Cyberdensscode/openTPU/docs/mxu_systolic.md

# A 2D systolic MXU (`MXU_IMPL=2`)

Goal: an MXU that scales to MCOLS = 8 (4 and 12 must also build) on the xc7k480t without the
broadcast fan-outs and the fabric adder tree that make MCOLS = 4 fail timing today
([mxu_study.md](mxu_study.md); the MCOLS = 4 builds of 2026-09-28: fmax 101-119 MHz at 97% of the
slices, worst paths route-dominated). Results must stay bit-identical to the ISA simulator, and
decode must not lose cycles.

**Since the MX column** ([mx_mxu.md](mx_mxu.md) section 9, branch `mx-rtl-prod`): the systolic
array is the only MXU (`IMPL` 0 and 1 are gone; `MXU_IMPL` must be 2), and everything after the
chain ends is new. The four `otpu_colend` DSPs and the per-column fp32 epilogue (i2f, the two
scale multiplies, the isum_4 loop) are replaced by `otpu_mxce` (rtl/tech: eight DSPs that take
each chain end times m << sh and a ninth that accumulates the whole row exactly in 48 bits), the
result FIFO holds the rows' integers, and E = MCOLS/2 lanes the columns share do the epilogue
once per output. The array below (hops, skews, the PAIR select in `otpu_pe`, row-gated pops,
command overlap) is unchanged; the column-end and epilogue lines of this page describe the
previous design.

## What changes, what stays

The MXU is a D x MCOLS dot-product engine: each advance, one D = 128-byte weight chunk (one K-block
of one output row, or two 4-bit blocks under PAIR) meets MCOLS activation blocks (ACT RAM, one per
column = one activation row), and each column reduces its 128 int8 x int8 products exactly, then
runs a per-column fp32 epilogue. `IMPL=0` broadcasts the decoded chunk to every column and sums in
a fabric tree; `IMPL=1` (study) sums along D in DSP cascades but still broadcasts the (skewed)
weights, and supports neither 4-bit weights nor PAIR.

`IMPL=2` keeps the MXU's front and back unchanged:

- the issuer, the chunk / scale FIFOs, the pop logic, the ACT RAM interface;
- the fp32 epilogue per column, in the ISA's order: i2f (exact) -> x weight scale -> x activation
  scale -> [PAIR: + partner column] -> isum_4 partial loop -> (p0+p2)+(p1+p3) -> result FIFO ->
  drain (ACC / ASCALE read-modify-write, RMAX). Integer sums are order-free; every fp op here is
  not, so the epilogue is not touched.

and replaces the dot product (operands -> s4, the exact integer block sum) with a systolic array.

## The array

```
            column 0            column 1                 column MCOLS-1
w chunk -> decode -> skew -> [hop] -> ... -> [hop] -> ... -> [hop]
                      |          |                        |
position i (chain g = i/16, stage k = i%16), in each column:
    act[j][i] (ACT RAM, delayed 1 + k + j: one SRLC32E per bit)
    M  = act * w          (DSP48E1 M register, one product per DSP)
    P  = PCIN + M         (stage k > 0; stage 0: P = M)  -> the chain's running sum
chain ends (8 per column): sub-block b = chains 2b, 2b+1 (32 positions, the 4-bit sub-block)
    v[b] = (chain 2b + chain 2b+1) * m_b   (otpu_colend: DSP b's pre-adder, multiplier, M)
    s4   = v0 + v1 + v2 + v3               (the four DSPs' PCIN cascade, DSP 3's P register)
deskew: column j's s4 delayed MCOLS-1-j cycles -> all columns aligned for the epilogue
```

- **Weights flow, not broadcast.** The chunk is decoded once (int8; int4 / E2M1 nibbles -> int8),
  skewed once per chain stage (shared SRLs, delay k), and then moves one register hop per column:
  column j sees it j cycles after column 0. Each hop register drives one DSP per position and the
  next hop: fan-out 2, not MCOLS.
- **PAIR (4-bit, 2M <= MCOLS):** columns j < M take the chunk's low block, columns j >= M its high
  block. Both decoded streams flow (2 x 8 bits per position per hop) and each column selects its
  stream with a per-command constant (`hi0[j]`) in the DSP48E1 itself (`otpu_pe`, in
  `rtl/tech/xilinx7/otpu_tech_dsp.sv`; the generic and DSP48E2 versions in `rtl/tech/generic`,
  `rtl/tech/xilinxus`: A = low, D =
  high, INMODE selects one through the pre-adder), so there is no fabric mux per position and
  column. `hi0[j]` drives the INMODE of the column's 128 DSPs (a 128 fan-out, the OOC's worst path
  at MCOLS 4: 152 MHz); it only changes between commands whose rows do not overlap.
- **Activations** stay per column (ACT RAM rows). Their delay, 1 (the decode register) + k (chain
  stage) + j (column), is at most 1 + 15 + 11 = 27 cycles for MCOLS <= 12: one SRLC32E per bit,
  the same cost as IMPL=1's chain skew alone. The column delay is free.
- **One product per DSP.** Two int8 products per DSP48E1 is not exact on a cascade (the study:
  the low field overflows after 3 accumulations), so each column has 128 product DSPs, 4 sub-block
  multipliers and the epilogue's fp multipliers: 138 DSP per column, 1,106 at MCOLS = 8 of the
  part's 1920 (measured; the rest of the design uses ~150).
- **The 4-bit sub-blocks** are 32 positions = two 16-stage chains, so the sub-block multipliers
  m_b apply at the chain ends, exactly as IMPL=0 applies them to its group sums. int8 uses
  m_b = 1. Chain length is fixed at 16 (`CL`).
- **Latency** S0 -> aligned s4: 1 (decode) + 16 (chain) + 1 (product) + 2 (v, s4) + MCOLS - 1
  (column skew, then deskew) = MCOLS + 19 cycles (23 at MCOLS 4, 27 at 8), against 7 for IMPL=0.
  It is paid once per MM command's drain (the study measured +17 cycles per MM chain for
  IMPL=1: negligible).
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
