Cyberdensscode/openTPU/docs/serve.md

# otpu-serve: an OpenAI-style server on the card

`otpu-serve` serves one model on the card to any number of clients over an OpenAI-compatible
HTTP API. It keeps every user's context, on the card while it runs and in the host's RAM and
on disk after that, and it decodes several users' requests together in one run of the card.
In that it follows SGLang: a prefix cache of contexts (SGLang's RadixAttention), a hierarchy of
memory under it (its HiCache: GPU, host RAM, disk), and continuous batching.

```sh
otpu-serve --model qwen3 --backend board                     # http://127.0.0.1:8000/v1
otpu-serve --model qwen3 --backend board --kv-ram-gb 8 --kv-disk-gb 32 --kv-dir /data/kv
otpu-serve --model lfm2 --backend board --port 8001          # one sequence: requests in turns
```

Any OpenAI client works against it (the `openai` Python package, checked: models, chat plain and
streamed with usage, completions):

```python
from openai import OpenAI
c = OpenAI(base_url="http://127.0.0.1:8000/v1", api_key="none")
r = c.chat.completions.create(model="Qwen3-0.6B", messages=[{"role": "user", "content": "Hi!"}])
```

## The API

| Route | |
|---|---|
| `POST /v1/chat/completions` | the chat template as otpu-chat renders it; `stream` (SSE), `n`, `max_tokens` / `max_completion_tokens`, `temperature`, `top_p`, `top_k`, `repetition_penalty`, `seed`, `stop` (strings), `stop_token_ids`, `ignore_eos`, `stream_options.include_usage`, `chat_template_kwargs.enable_thinking`, `skip_special_tokens`; content as a string or text parts (and `image_url` parts and `max_slices` on a model with a vision side) |
| `POST /v1/completions` | a prompt string or token ids, `echo`, the same sampling and stops |
| `POST /generate` | SGLang's native call: `text` or `input_ids` (one, or a list), `sampling_params` (`max_new_tokens` (default 128), `temperature`, `top_p`, `top_k` (-1: all), `repetition_penalty`, `stop`, `stop_token_ids`, `ignore_eos`, `n`), `stream` (each event the whole text so far); `output_ids` and `meta_info` (prompt, completion and cached tokens, `finish_reason`, `e2e_latency`) |
| `GET /v1/models` | the model, its context length (`max_model_len`) |
| `GET /v1/stats` | the queue, throughput, the slots, the KV store and prefix cache, the steps' timing |
| `GET /health`, `/health_generate` | ok; a streamed MoE's 503 `warming` while its expert pool is read into the page cache (below) |
| `GET /get_model_info`, `/get_server_info` | |
| `POST /flush_cache` | forget every saved context and what idle slots hold |
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
