Cyberdensscode/openTPU/docs/img/asic-small-candA-macros.png

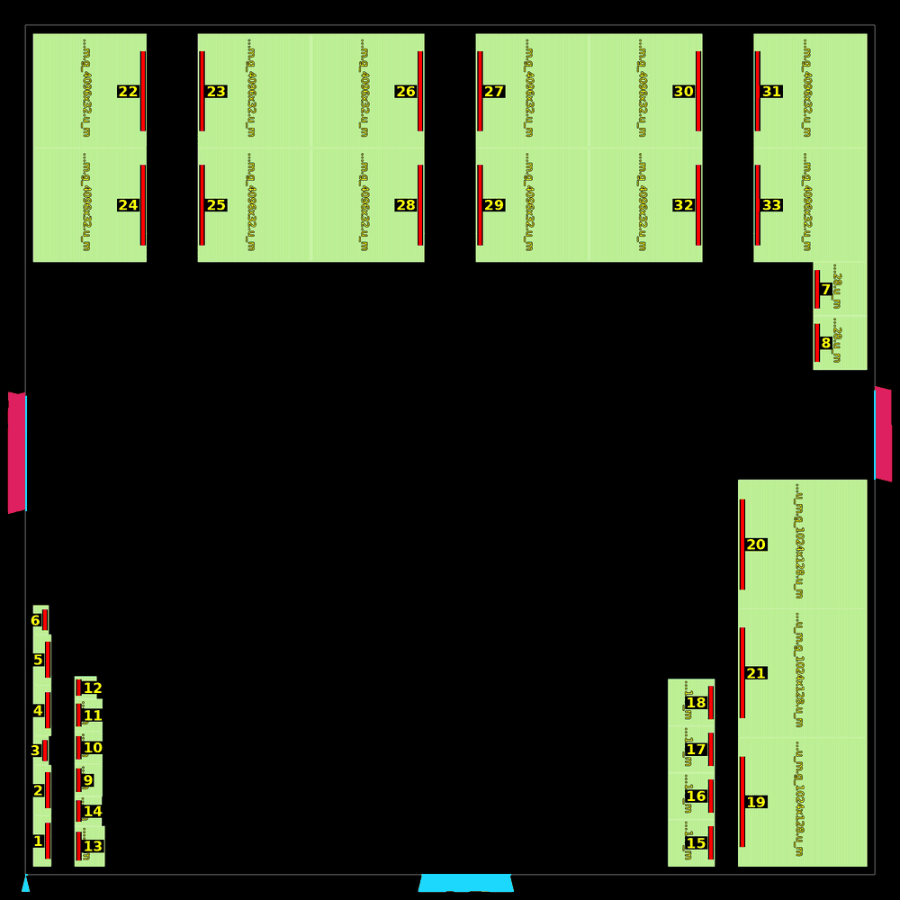
docs/img/asic-small-candA-macros.png
