Cyberdensscode/openTPU/docs/img/asic-small-candA-routed.png

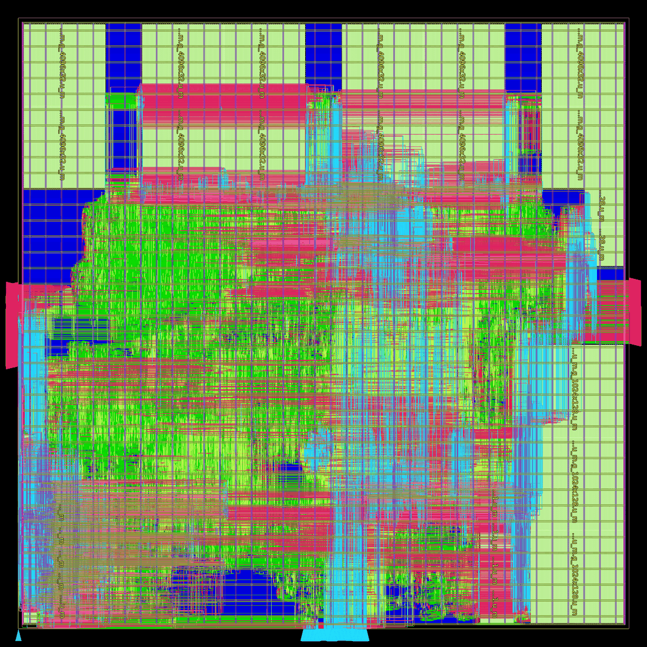
docs/img/asic-small-candA-routed.png
