Cyberdensscode/openTPU/docs/img/asic-small-candB-macros.png

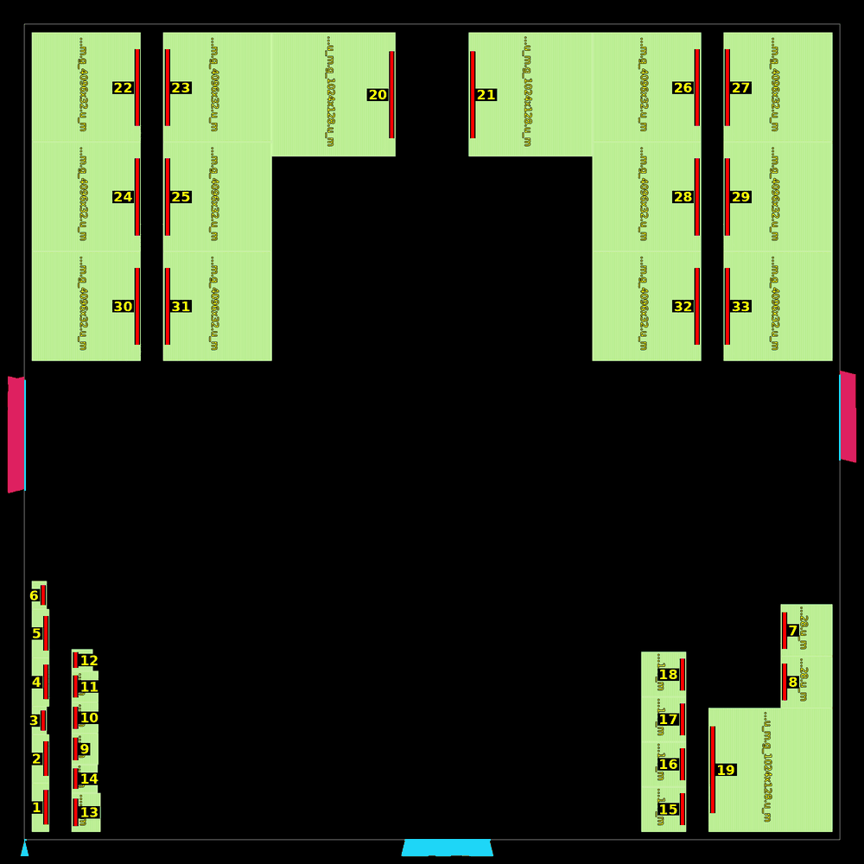
docs/img/asic-small-candB-macros.png
