Cyberdensscode/openTPU/asic/nangate45/results/small/final_all.png

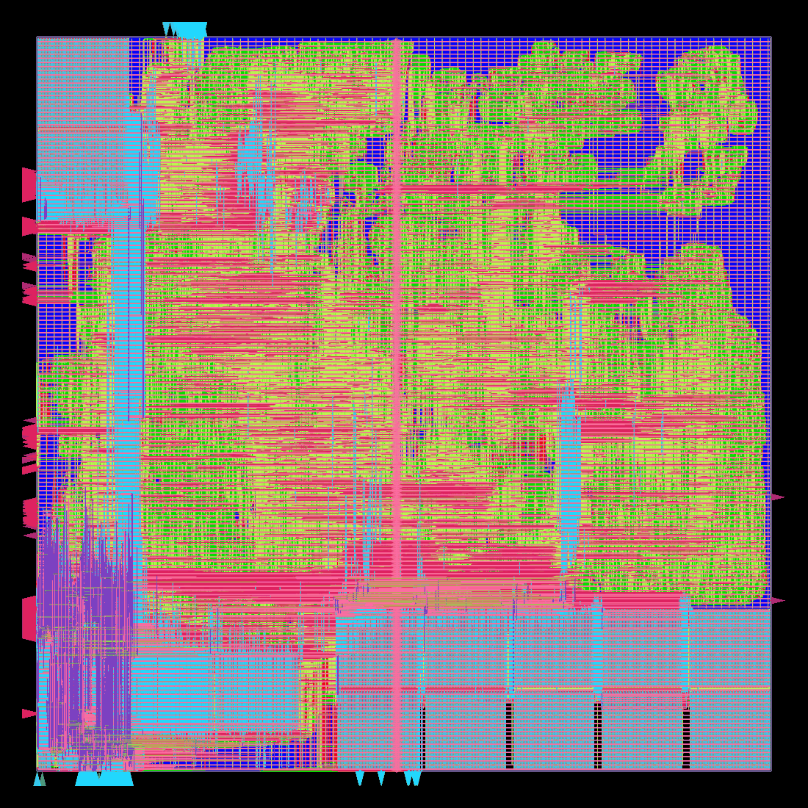
asic/nangate45/results/small/final_all.png
