Cyberdensscode/openTPU/opentpu/host/smi.py

"""otpu-smi: the state of openTPU cards, like nvidia-smi.

    otpu-smi                      one table per device (/dev/xdma*): bitstream, link, DDR3
                                  calibration, temperature, power (measured or estimated),
                                  DRAM, utilization over a short interval, the owning process
    otpu-smi -l 1                 again every second (utilization over each second)
    otpu-smi --json               the same as JSON (a list, one object per device)
    otpu-smi -q                   every detail, raw counters included
    otpu-smi --dev /dev/xdma1     one device (repeatable)
    otpu-smi --sim                the Verilator board model: counters over one run of the
                                  bring-up demo program (both samples in one simulation)
    otpu-smi --fake               an in-memory card with synthetic counters (demo, tests)
    otpu-smi -l 0.5 --samples 20 --csv util.csv
                                  loop, stop after 20 samples, append each to a CSV

The default table names the bitstream's capability bits (CAPS) and, in -l mode, a sparkline
of MAC / DRAM / RUN over the last samples.

A monitor: it only reads registers (and writes SNAP, which latches the free-running counters
into their shadows without disturbing anything), never takes the device lock, and reads the
runner's status file for the process, the model, DRAM use and tokens/s. Utilization is the
counter delta between two SNAPs over the UPTIME delta. On a register map 1 bitstream the
counters, the temperature and the power estimate are n/a.

Power is measured when the bitstream has the I2C pins (CAPS.i2c) and a PMBus device on the
card's I2C buses reports it (opentpu/host/i2c.py: read-only transactions under the I2C lock;
the first query scans the buses, later ones reuse <run dir>/<dev>.i2c.json). Otherwise it is
the estimate from Vivado's power report, marked "~ ... estimate". --no-i2c skips the buses.
"""
from __future__ import annotations

import argparse
import csv
import datetime as _dt
import glob
import json
import sys
import time
from pathlib import Path

from . import power as P
from . import regs as R
from .board import Board, rates
from .runstate import devname, read_status

VERSION = "0.3.0"
ROOT = Path(__file__).resolve().parents[2]
POWER_JSON = ROOT / "build" / "vivado" / "reports" / "power.json"


def find_devices() -> list[str]:
    return sorted(p[:-len("_user")] for p in glob.glob("/dev/xdma*_user"))


def pcie_link(dev: str) -> str | None:
    """'2.5 GT/s PCIe x8' from sysfs (the XDMA driver's class device), None if unknown."""
    base = Path(f"/sys/class/xdma/{devname(dev)}_user/device")
    try:
        sp = (base / "current_link_speed").read_text().strip()
        wd = (base / "current_link_width").read_text().strip()
    except OSError:
        return None
    return f"{sp} x{wd}"


# ------------------------------------------------------------------------------ sampling
def query(t, dev: str, interval: float = 0.2, prev: dict | None = None,
          power_json=POWER_JSON, sleep=time.sleep, i2c: bool = True) -> dict:
    """One device's state. Utilization over `interval` seconds (two snapshots), or since
    `prev` (the "counters" of an earlier query) when given."""
    b = Board(t, check=False, lock=False)
    ident = t.reg_read(R.R_ID)
    d = {"device": dev, "time": time.time(), "id": ident, "ok": ident == R.ID_OTPU,
         "link": "ok" if ident == R.ID_OTPU else
         "down (registers read 0xffffffff)" if ident == 0xFFFFFFFF else
         f"no openTPU (ID {ident:#010x})", "pcie": pcie_link(dev)}
    if not d["ok"]:
        return d
    i = b.info()
    d.update(regmap=i["regmap"],
             bitstream={"D": i["D"], "MCOLS": i["MCOLS"], "LANES": i["LANES"],
                        "core_mhz": i["core_khz"] / 1e3 if i["core_khz"] else None,
                        "build_id": i["build_id"], "ddr_mts": i["ddr_mts"]},
             calib=i["calib"], status=i["status"], running=i["running"], caps=i["caps"],
             temp_c=i["temp_c"])
    if b.v2:
        s0 = prev if prev else b.snapshot()
        if not prev:
            sleep(interval)
        s1 = b.snapshot()
        _derive(d, s0, s1, i["core_khz"])
    else:
        d.update(counters=None, util=None, sample=None, dram_gbs=None)
    st = read_status(devname(dev))
    d["process"] = st
    d["dram"] = st["dram"] if st and not st.get("stale") else None
    d["power"] = _power(d, power_json)
    d["measured"] = _measured(t, i["caps"]) if i2c else None
    return d


def _measured(t, caps: dict | None) -> dict | None:
    """Board power (PMBus) and temperature (LM73) over I2C, or None without the I2C pins."""
    if not caps or not caps.get("i2c"):
        return None
    from . import i2c as I2C
    try:
        return I2C.measured(t)
    except OSError:
        return None


def _derive(d: dict, s0: dict, s1: dict, core_khz: int | None) -> None:
    r = rates(s0, s1, core_khz)
    d["counters"] = s1
    d["sample"] = {"cycles": r["cycles"], "seconds": r["seconds"], "ipc": r["ipc"],
                   "dram_beats": r["dram_beats"]}
    d["util"] = r["util"]
    d["util"]["DRAM"] = r["dram_beats"] / r["cycles"] if r["cycles"] else 0.0
    d["dram_gbs"] = r["dram_gbs"]
    d["dram_rd_gbs"], d["dram_wr_gbs"] = r["dram_rd_gbs"], r["dram_wr_gbs"]


def power_report(d: dict, power_json=POWER_JSON) -> Path | None:
    """The Vivado power report for the loaded bitstream: power_json when it is not the default,
    else the saved build whose directory names the bitstream's BUILD_ID
    (build/deploy_*_<sha7>/reports/power.json), else the last build's."""
    if power_json and Path(power_json) != POWER_JSON:
        return Path(power_json)
    bid = (d.get("bitstream") or {}).get("build_id")
    if bid is not None:
        for f in sorted(ROOT.glob(f"build/*{bid:08x}"[:-1] + "*/reports/power.json")):
            return f
    return POWER_JSON if POWER_JSON.exists() else None


def _power(d: dict, power_json) -> dict | None:
    power_json = power_report(d, power_json)
    pj = P.load(power_json) if power_json else None
    if pj is None or not d.get("util"):
        return None
    e = P.estimate(pj, d["util"])
    e["source"] = str(power_json)
    return e
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
