Cyberdensscode/openTPU/rtl/exp/mx_mxu/mx_top.sv

// EXPERIMENTAL (docs/mx_mxu.md): the out-of-context top of the MX MXU's datapath, from the
// chunk and the ACT rows to the read-modify-write lanes: NCOL physical columns of two stationary
// rows each (ROWS = 2 NCOL, the virtual MCOLS), the rows' 48-bit accumulators, PAIR's add, a
// result FIFO and E shared epilogue lanes. The family file (otpu_mx_x7.sv: pumped DSP48E1s,
// otpu_mx_us.sv: packed DSP48E2s) gives the columns, the front and the clocks. base_top.sv is
// today's datapath with the same surroundings. Every input is registered in clk_s (the ports carry
// no timing), the outputs too; the issuer, the FIFOs of chunks and scales, the TMEM addresses and
// RMAX are not here (the same in both).
//
// Chunk t (its inputs in cycle t at the ports): the 128-byte chunk (wf: 0 int8, 1 int4, 2 E2M1;
// h: a 4-bit chunk's high half without PAIR), its two scale words (low / high stream: dw [7:0],
// m_b [8+6b +: 6]), the rows' activation blocks and their exponent words (da: 4 x 8 bits), the
// row flags (v, first, last) and, with the row's last chunk, Sw[n]. Per command: hsel (a physical
// column's stream: PAIR puts the low rows in columns 0 .. NCOL/2-1 and the high rows in the rest,
// so row j's partner is row j + ROWS/2), pair, fmt, m (results per row), Sa[r], old / alpha (the
// RMW's operands, from TMEM in the MXU).
module mx_top
  import otpu_fp::*;
  import otpu_mx_fam::*;
#(
  parameter int NCOL = 2,
  parameter int E = 2,
  parameter int D = 128,
  parameter int RF = 64
) (
  input  logic                          clk_in,
  input  logic                          rst,
  input  logic [2*NCOL-1:0][D-1:0][7:0] x_in,
  input  logic [D-1:0][7:0]             chunk_in,
  input  logic [1:0]                    wf_in,
  input  logic                          h_in,
  input  logic [31:0]                   sw_lo_in,
  input  logic [31:0]                   sw_hi_in,
  input  logic [2*NCOL-1:0][31:0]       da_in,
  input  logic [NCOL-1:0]               hsel_in,
  input  logic                          pair_in,
  input  logic                          fmt_in,
  input  logic [7:0]                    m_in,
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
