Cyberdensscode/openTPU/(commit log)

2026-10-08 otpu-chat keeps the KV cache across turns: a turn rolls the context back to the common prefix of its rendering and what the device holds (Engine.rollback) and feeds the rest, instead of re-prefilling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
    opentpu/llm/snapshot.py: the KV caches go back to any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
2026-10-08 tools/qual/chatkv.py: the card check of a chat's KV cache across turns: a scripted greedy conversation through Chat (--backend board; isa / board-sim for a dry run, at the card's configuration), each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
    [chatkv.py]
2026-10-08 Snapshots on the host keep a slice's regions as one array (restored by offset, as the device area's layout: the same bytes for either DeltaNet state slot whatever their regions' joins); test_mtp_roll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
2026-10-08 tools/qual/chatkv.py: no cycles printed on the ISA simulator (it counts none: tokens and runs)
2026-10-08 Chat passes logits=False only for a prompt's part up to the snapshot (a stateful engine's): an engine whose prefill_chunks takes the tokens alone runs as before (test_host's StubEngine: test_chat_tur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
    [chat.py, chat_tui.py]
2026-10-08 streamed: moe_card's engine wiring as a library (opentpu/host/streamed.py), for otpu-chat and moe_card alike, and pack_pool sums. streamed.engine builds a streamed MoE's Engine with the settings meas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
    [moe_card.py, pack_pool.py, streamed.py]
2026-10-08 otpu-chat: MoE models bigger than the card's DRAM, their experts streamed (--model lfm2-8b, qwen35-35b, gemma4-26b), and the scripted chat that checks them on the card (tools/qual/chatmoe.py, chatmoe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
    [chat.py, chat_tui.py, chatmoe.py, test_chatmoe.py]
2026-10-08 docs: chatting with a streamed MoE (docs/offload.md 14, docs/host.md 6, README). How to chat with LFM2.5-8B-A1B, Qwen3.5-35B-A3B and gemma-4-26B-A4B; where the pool goes (pool-fp4.bin beside the chec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
2026-10-08 otpu-chat: a default top-k above 64 (or none) becomes 64, every model alike, so that the decode loop stays on the card (the user's decision; LFM2.5-8B-A1B's generation_config.json asks for 80, which 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
2026-10-08 Streamed MoE chats roll back too (on chat-kv): otpu-chat and chatmoe.py pass snapshots=1 through streamed.engine (Engine's own), so a turn whose rendering parts from what was fed rolls back to the la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
2026-10-08 progcache: the host's runtime variables out of the key. otpu-lock runs every command with OTPU_LOCK_HELD and its pid in OTPU_LOCK_PID; both were in the key (every OTPU_* variable but RUNTIME_ENV's), 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
    [progcache.py, test_progcache.py]
2026-10-08 A whole-image cache (opentpu/imgcache.py): a model opened before opens in seconds. Engine builds its image through imgcache.build: keyed by the checkpoint (its config.json and weight files' names, si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
    [chat.py, imgcache.py, prebuild.py, test_imgcache.py]
2026-10-08 otpu-chat loads the tokenizer on a thread while the model loads (load_tokenizer): importing transformers, and torch with it, took 2.5 s of a warm open's 3.2 s on omarchy, before the image was read; n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
2026-10-08 Gemma 4 and the image caches; an image cache it cannot write is no error. gather.pack_records (Gemma 4's PLE records, whose fp4 search took 697 of 773 s of a build on one core) quantizes its blocks w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
    [imgcache.py, test_gemma4.py, test_imgcache.py]
2026-10-08 qcache.Batch hashes and reads the cache on threads: a build whose matrices are all in the 4-bit cache (a new KV capacity, the first open after any source change: the image cache misses) hashed 9.7 GB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
2026-10-08 docs: parallel image builds and the image cache. board.md, a new section (Image builds: in parallel, and cached whole): the 16-minute cold open of 2026-10-08 and why, quantize_rows' row pieces (one c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
2026-10-08 test_imgcache: a MoE through the image cache. A tiny Qwen3.5-MoE checkpoint on disk (fused expert tensors, as the real ones) with two expert slots a layer: the hit's image is the build's, and its eng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
    [test_imgcache.py]
2026-10-09 docs/offload.md 14.5: Qwen3.5-35B-A3B's chat on the card (opentpu, build 1025907f, tree 171a1b50), against its ISA reference (24a7e3f8, omarchy): both turns' tokens the same; 1720 slots, the prompt l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
2026-10-09 MODELS: Gemma 4's short names are the instruct checkpoints: gemma4 gemma-4-E2B-it, gemma4-26b gemma-4-26B-A4B-it, and gemma4-e4b gemma-4-E4B-it (new). The base checkpoints (gemma-4-E2B, ...) have no 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
    [test_autodecode.py]
2026-10-09 otpu-chat with Gemma 4's instruct templates. A reply's text keeps the special tokens the model wrote (Detok, Chat._finish: skip_special_tokens=False): Gemma 4 marks its thinking channel's ends specia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
    [chat.py, chat_tui.py, test_chatkv.py, test_host.py]
2026-10-09 otpu-chat --backend isa (the default) runs Gemma 4 in the card's configuration: the simulators' default is the design's two slices, onto which Gemma 4 (one KV head) does not map, so a Gemma chat on t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
    [chat.py, test_gemma4.py]
2026-10-09 tests: test_chatmoe's tiny checkpoints carry a chat template (otpu-chat refuses a checkpoint without one: test_otpu_chat_runs_a_streamed_moe and test_otpu_chat_clamps_the_models_top_k stopped there);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
    [test_chatmoe.py, test_validate.py]
2026-10-09 chatkv.py on Gemma 4: its recording sampler takes the model's soft cap (Chat refuses a sampler of another one: the tool stopped at 'the sampler's softcap None is not the model's 30.0' before its firs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
    [chatkv.py, test_chatkv.py, test_gemma4.py]
2026-10-09 formats_scan.py ppl --ids FILE: score the formats on another text's token ids (a JSON list, or an object with ids). tools/chat_text.py makes such a text from a chat: an instruct model's own replies t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
2026-10-09 test_gemma4's test_otpu_chat_on_the_isa_simulator: ask_plain's stream taken at the call (as test_chatmoe's), so the reply's line is captured when another test imported chat.py first (its default sys.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
    [test_gemma4.py]
2026-10-09 formats_scan.py scan --ids too (ppl's: another text's token ids). test_gemma4's test_formats_scan_text: docs/isa.md's ids start with <bos> for a Gemma 4 checkpoint whose tokenizer adds none, --ids re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
    [formats_scan.py, test_gemma4.py]
2026-10-09 formats.MIXES: no mix for Gemma 4 E2B: on gemma-4-E2B-it, the chat's checkpoint, every mix fails the rule, so otpu-chat's --wformat auto takes int8 (the fp4 PLE table, the int8 head; 6.37 tok/s on th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
    [perf_qwen.py, refs.py, test_autodecode.py, test_gemma4.py]
2026-10-09 formats_scan: a Gemma 4 variant's PLE table from its image laid out in unbounded DRAM (the placement is by the card's 4 GiB either way), so a reference that does not fit the card has one: E4B's int8 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
    [formats_scan.py, test_gemma4.py]
2026-10-09 gemma4: E4B's formats by fit are gemma-4-E4B-it's pick, the head and the gate / up projections of the first half of the own-KV layers in fp4 (head=fp4,gateup@0-11=fp4; Spec.fit_formats), three layer 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
2026-10-10 targets: one file per target (targets/*.toml: ypcb-00338, bcu1525, nangate45, nangate45-small) and opentpu/target.py, the loader everything derives from (Config, the simulators' uarch, the tops' para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
2026-10-10 rtl: the cell families and the FPGA shell (docs/targets.md "The RTL's layers"). The systolic MXU's cells otpu_pe and otpu_colend leave otpu_mxu.sv for rtl/tech/<family>/otpu_tech_dsp.sv: generic (the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
2026-10-10 host: otpu-selftest / otpu-diag name the target a map-4 bitstream was built from (board.config_summary: its slices and channels, DDR3 / DDR4 from the target), target.by_platform; README points at doc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
2026-10-10 bcu1525: the board's pins, DDR4 memory core and Vivado flow, before the hardware (docs/bcu1525.md). Pins: boards/bcu1525/scripts/gen_pins.py writes constraints/ddr4_c0..3.pins.xdc and bcu1525_pins.xd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
    [csr.csv]
2026-10-10 otpu_board: S slices (parameter S, default 1), each on two memory channels (slice s on n_* 2s and 2s + 1) through its own otpu_native_dram, the collective unit across them (gnt the AND of every slice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
    [otpu_board.sv, otpu_chmem.sv, otpu_ctrl.sv, otpu_native_mem.sv, tb_board.sv]
2026-10-10 host: multi-slice boards. board.channel_map(info): the card's channels from a register map 4 bitstream's CFG_* registers, channel j = 2s + c (slice s's channel c) at j x the bytes a slice addresses p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
    [board.py, fake.py, regs.py, test_board.py]
2026-10-10 bcu1525: the target's bring-up values and the DMA map the host now uses. targets/bcu1525.toml: mem_mts 1600 (LiteDRAM's USPDDRPHY at 200 MHz first; the RDIMMs are DDR4-2400, 300 MHz once the controll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
2026-10-10 docs/bcu1525.md: phase 2's state. Section 5: XDMA's DMA window is 8 GiB, channel j = 2s + c at j x 2 GiB (board.channel_map from CFG_SLICES / CFG_DRAM; the YPCB's two channels are the same rule), the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
2026-10-10 bcu1525: the board top. rtl/boards/bcu1525/otpu_fpga_top_bcu.sv: the four DIMMs' 300 MHz clocks (IBUFDS + BUFG each; clk300_1, SLR1, also the block design's), one otpu_ld4 per DIMM (its CSRs on core_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
    [otpu_bcu_sys.sv, otpu_bd_wrapper_stub.sv, otpu_fpga_top_bcu.sv, target.py, test_target.py, unisim_dsp48e2_stub.sv, unisim_stubs.sv]
2026-10-10 bcu1525: a first SLR floorplan (unverified) and the top's crossing constraints. constraints/bcu1525_floorplan.tcl (unmanaged Tcl, late, implementation): slice 0 with DIMM C0's core and bridge in SLR0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
    [board.py, check_offline.py, otpu_axi_split2.sv, otpu_bcu_sys.sv, tb_board.sv, test_board.py]
2026-10-10 bcu1525: DDR4 bring-up over the cores' CSRs (otpu-ddr4) and two fixes in the DDR4 core. opentpu/host/ddr4.py: DIMM d's LiteDRAM core in BAR0 at R_DDR4 + d x DDR4_STRIDE (0x40000 + d x 0x10000, vivado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
    [csr.csv]
2026-10-10 otpu-ddr4: the BIST holds the device lock (a DMA transport's: it writes over the DRAM; status and ecc read registers, as otpu-smi), and the tool closes the transport it opened. tests/test_ddr4.py 3 p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
2026-10-10 otpu_board: at S > 1 the control, the status and the collective cross SLRs through registers. Every signal between a slice and the shell goes through two otpu_xr stages each way per slice (g_xs: u_*_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
    [otpu_board.sv, otpu_coll.sv, otpu_ctrl.sv]
2026-10-10 bcu1525 floorplan: the board's new crossings. pb_slice0 / pb_slice1 take each slice's otpu_xr receive stage down, send stage up and otpu_coll_port (slice 0 also its activity bundle's send stage), pb_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
    [otpu_board.sv]
2026-10-10 bcu1525: the day-one checklist and a Vivado preflight. run_vivado.sh runs scripts/preflight.tcl first (PREFLIGHT=0 skips it): the target's part (T_PART) must be installed (exit 2: the installed famil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
    [diag.py, selftest.py, test_ddr4.py, test_host.py]
2026-10-10 docs/bcu1525.md section 7: the TMEM_URAM=1 estimate measured (yosys PID 22666, the same one-slice xcup run with the 48 TMEM bank memories marked ram_style ultra, as tmem_uram.xdc marks them; 48 objec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
2026-10-10 tests/test_board.py: test_bar_and_gather_across_slrs_on_board_model, BAR and GATHER through the BCU1525's SLR crossings (otpu_board S = 2, g_xs: otpu_coll_hub and a port per slice) on the board model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
    [test_board.py]
2026-10-10 tmem: a banked implementation for ASICs (TMEM_IMPL 1): three copies of 1R1W bank RAMs instead of one per read port
    otpu_tmem IMPL 1: NCP copies (CPY: each read port's copy), each LANES banks of one otpu_ram_1r1w
    (rtl/tech/generic/otpu_tech_ram.sv, the technology RAM wrappers: 1R1W, 1R1W with byte enables,
    1RW; inferred here, SRAM macros in an ASIC's rtl/tech). A copy's bank serves the one port granted
    in it, its address from that port's granted lanes (r_en); writes go to every copy (WPB 1); the
    registered write stage, the bypass and the lanes' data path are IMPL 0's. IMPL 0 (the FPGA's, a
    copy per read port) is unchanged: its bank arrays and their code stay where they were.
    otpu_slice TMEM_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
2026-10-10 The core's large RAMs on the technology RAM wrappers; tools/asic/fakeram.py, 1RW and 1R1W abstract SRAM macros for NanGate45
    The memories an ASIC builds from SRAM macros now go through rtl/tech's otpu_ram_1r1w /
    otpu_ram_1r1w_be (the generic file infers them, with the ram_style the FPGA had; the ASIC file
    maps them onto macros): IMEM (otpu_seq u_imem; its simulation load writes the RAM's words, the
    wrapper's zero start off for it: ZERO), the ACT RAM's pieces and block scales (u_act with byte
    enables, u_asc), the DMA's chunk buffer (u_lb), the MXU's chunk FIFO (u_fd, was otpu_ram_sdp, which
    stays for now) and scale FIFO (u_fs: ws0r is its read register), the stream engine's delay buffer
    (u_ub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
2026-10-10 asic: the ASIC block (rtl/asic/otpu_asic_top.sv), the macro-tiled technology RAMs and the NanGate45 flow through OpenROAD-flow-scripts
    rtl/asic/otpu_asic_top.sv: one slice (TMEM_IMPL 1, RPB 1, WPB 1) and its collective unit, the
    slice's memory ports at the boundary (the DRAM side, PHY and controller, is the platform's).
    rtl/tech/asic/otpu_tech_ram.sv: otpu_ram_1r1w / _1r1w_be / _1rw tiled onto leaf macros of at most
    128 bits x 4096 words (depth tiles with a registered read select); the leaves are generated per
    design.
    tools/asic/flow.py prep | run | report | all POINT: elaborate once with yosys-slang (the leaves as
    parameterised black boxes) to list the RAM tiles, generate their macros (fak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
2026-10-10 targets: the technology RAMs in every file list (target.TECH: rtl/tech/generic/otpu_tech_ram.sv for generic / xilinx7 / xilinxus, rtl/tech/asic/otpu_tech_ram.sv for asic; rtlsim.RTL_SOURCES, the boar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
2026-10-10 tech: tests/test_tech_ram.py (sim/tech/tb_tech_ram.sv): the ASIC's technology RAMs, tiled onto tools/asic/fakeram.py's macro models with flow.sram_map's leaves, read what the generic ones read, cycle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
    [otpu_tech_ram.sv, tb_tech_ram.sv, test_tech_ram.py]
2026-10-10 tests: test_tmem_dump_is_the_ram faults VPU B's copy (port 4) instead of VPU A's: port 4 holds a TMEM copy of its own in both TMEMs (a copy per read port, and the banked one's copy 1), port 3 reads t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
    [test_rtl.py]
2026-10-10 asic: tools/asic/paths.py names a run's paths by unit and stage. paths.tcl (ORFS `make run`, any stage: 6_final, 4_cts, 5_route) writes the worst full paths, every endpoint's worst path (summary) and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
2026-10-10 asic: flow.py report takes the latest stage's report (6_finish, 5_global_route or 4_cts_final): the worst slack with the ports' 20% budgets (fmax_io_mhz), the clock's minimum period register to regis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
2026-10-10 asic/nangate45/README.md: the points by target (small = nangate45-small, card = nangate45), the commands (prep / run / report, resuming and cleaning a stage, stopping at a make target, paths.py at an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
2026-10-10 docs/asic.md: the results so far. nangate45-small after global route: 7.02 mm² die, 1.18 mm² of standard cells (590 K instances), 27 macros (233 KiB, 1.31 mm²); 416 MHz register to register (422 afte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
2026-10-10 tests: test_asic_flow.py (no OpenROAD): every ASIC target is a design point, a point's parameters are otpu_asic_top's with the target's values and its clock the target's core_mhz; the sources are the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
2026-10-10 asic: the SDC drops hold checks at the block's ports: the ideal virtual clock against the propagated core clock (~1.2 ns of insertion delay) made the input paths hold violations (nangate45-small: 218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
2026-10-10 asic: no standard-cell row narrower than 60 um (asic/nangate45/tapcell.tcl: the platform's tapcell with -row_min_width 60, TAPCELL_TCL): nangate45-small's final power-grid check failed (PSM-0069, VSS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
    [flow.py]
2026-10-10 docs/asic.md: nangate45-small routed and reported (signoff extraction): 7.02 mm² die, 1.18 mm² of standard cells (94 K flip-flops, 373 K gates), 27 macros 1.31 mm²; 419 MHz register to register with 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
2026-10-10 docs/asic.md: what the banked TMEM costs in cycles: a Qwen3-0.6B decode token on the RTL (tools/asic/tmem_cycles.py, omarchy) 4,819,205 cycles against 4,815,735 with a copy per port (+0.07%), results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
2026-10-10 docs/asic.md: nangate45 (the card's arch) synthesized and floorplanned: 30.6 mm² die at 35%, 4.04 mm² of standard cells (1.76 M instances), 113 macros 6.62 mm²; the area per unit (TMEM 4.05 mm², 3.99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
2026-10-10 bcu1525 + asic-flow: the BCU1525's file lists take the technology RAMs (rtl/tech/generic/otpu_tech_ram.sv after the DSP cells in boards/bcu1525/Makefile and vivado/create_project.tcl, as target.sourc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
2026-10-10 docs/asic.md: nangate45 (the card's arch) after CTS: 2.02 M instances, 4.36 mm² of standard cells, 113 macros on a 30.6 mm² die; 178 MHz register to register (5.60 ns), 156 MHz with the ports, 3.34 W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
2026-10-10 docs/asic.md: the card's fp stages after CTS: their own logic meets 2.5 ns (fmul s1 -> s2 +0.76 ns, fmul s2 -> the next s1 +0.46, fadd s1 -> s2 +0.95, s2 -> s3 +0.92) while every path into them fails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
    (cherry picked from commit 7f46b8803dfea87e72987526a34290d63a15dd0f)
2026-10-11 test_tourney after the RTL layers: every RTL file of the card's build (target.sources("ypcb-00338")) is some unit component's, the other targets' files (rtl/asic, rtl/boards/bcu1525, rtl/tech/asic, x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
    [test_tourney.py]
2026-10-11 decode_profile: the Board.write wrapper passes the slice argument through (Board.write(addr, data, s=0) since the multi-slice host). Its fixed (self, addr, data) raised TypeError on every Board.write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
    [decode_profile.py]
2026-10-11 size-general: the compiler, kernels and models take every size from the Config, so one tree compiles for the card, the BCU1525 (S = 2), the NanGate45 targets and the design point (docs/compiler.md "S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
2026-10-11 tests: each pytest session takes a device-lock / status directory of its own (OTPU_RUN_DIR = <tmp>/otpu-run-<user>-<pid>, removed at the end; the default is /tmp/otpu, shared by the host). A fake boa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
2026-10-11 test_se_vpu: the stream front's testbench compiles rtl/tech/generic/otpu_tech_ram.sv (otpu_se_tail's ub is an otpu_ram_1r1w since the ASIC RAM wrappers): its own file list missed it, %Error-MODMISSIN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
    [test_se_vpu.py]
2026-10-11 progcache: the cache key leaves out the modules no image build or compile runs (UNKEYED: lens.py, profile.py, hwtrace.py, reference.py, rtlsim.py, simtmp.py, llm/rtl_backend.py), so an edit to the pr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
    [imgcache.py, progcache.py, test_progcache.py]
2026-10-11 serve/kvio: a context's bytes on the host. The positional KV caches' first n positions (K rows, K scales, V^T tiles of vt_tile(cap) tokens, V scales; Gemma 4's _KV rows with their scales) in pages of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
2026-10-11 serve/store: the KV store on the host. BlobStore: byte blobs in RAM up to a budget, the least recently used spilled to files by a writer thread (read from memory while written), up to a disk budget p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
2026-10-11 serve/scheduler: the device's worker. One thread owns the Engine; requests (prompt ids, sampling, stop ids and strings, max_new) admitted up to max_running and run in turns: a new request continues t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
2026-10-11 serve/api: otpu-serve, an OpenAI-style HTTP API (the standard library's server). POST /v1/chat/completions (the chat template as otpu-chat renders it, thinking per chat_template_kwargs, content parts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
2026-10-11 llm/batch: batched decode steps on the device. Engine(batch=B, batch_area=True): the lookup tables serve every sequence (sequence 0 keeps the resident decode, the generate loop and the prompt runs), 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
2026-10-11 serve/batching: continuous batching over KV slots. BatchWorker on an Engine(batch=B, batch_area=True): up to B requests at once, each in its own slot; per iteration the waiting requests take free slo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
2026-10-11 serve_bench: sampled throughput levels (the model's sampling, seeded per client)
2026-10-11 batch: a step's head through _head (the chunk can be set in the area); Steps.timing (device cycles, compile waits, run time) in the batching worker's usage (step_timing)
2026-10-11 docs/serve.md: otpu-serve (the API, the KV cache's pages, store and prefix cache, requests in turns and batched in KV slots, the card's measurements of 2026-10-09: time-sliced 24-25 tok/s at 1-8 clie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
2026-10-11 tools/batch_bench.py: batched steps against the decode loop on one image (device Mcycles and wall time per run and per token, per row count, greedy and sampled; --trace: a decode step and steps of R 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
2026-10-11 batch: span programs. A step's program serves its rows for up to a block of steps: row r at position p_r + t, t the run-time step in the io block's step word (loaded and multiplied into the argument 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
2026-10-11 serve: the first token on the card, prompts in feed runs. A prompt feeds all but its last token; the last one is the request's first decode row (batched: a step's row with its Greedy / Sampler sink; 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
2026-10-11 batching: a prompt's join compiled ahead. AHEAD_JOIN (3) feed runs before a prompt is fed, the step it joins (the decoding requests that many steps on, its row at the prompt's last token) is compiled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
    [batching.py, test_batch_steps.py]
2026-10-11 batching: chunked prefill by a token budget, coming steps compiled ahead. Each iteration feeds the prompts being fed, oldest first, up to --chunked-prefill-size tokens (default 64; was one feed run o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
    [api.py, batching.py, test_serve_batching.py]
2026-10-11 docs/serve.md: the card's run of span programs and feed runs (6c3a1c75, 2026-10-09 19:40-19:45): 4 / 8 clients 77.7 / 75.7 tok/s (per-step programs: 53.3 / 50.1), 8 sampled 78.5 (46.3), TTFT at 8 cli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
2026-10-11 serve_bench: the users part (--users N, default 16; --user-tokens): every user's first turn at once, then every user's second turn at once (more users than slots: contexts from the slots, host RAM or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
2026-10-11 batch: Steps.timing splits a run's host time (the io write, start, wait, the picks' read); batch_bench prints them per run
2026-10-11 batch: fewer inline compiles when requests come and go (the card's 16-user run compiled 74 of 129 step programs inline, 4.9 s of 62). A step's rows in slot order (the worker's steps and _rows_at's pr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
2026-10-11 docs/serve.md: the card's 16 users on a 50 MB RAM tier (26 contexts spilled, 14 second turns from disk, replies equal to cold runs), host time per run (0.5 ms plus the wait), blocks of MCOLS slots an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
2026-10-11 serve: the engine's per-run stats trimmed to the last 1024 between iterations (one dict a device run, ~90k an hour batched: a server runs for days)
2026-10-11 otpu-serve: a listen backlog of 1024 (socketserver's 5: the card host reset one of 16 clients connecting at once, Linux with syncookies). Test: 64 clients connecting at the same moment
    [api.py, test_serve_api.py]
2026-10-11 batch: feed programs shared by every prompt. A feed run's program is compiled at its attention block's start plus its phase in feed_rows() (Steps._canon), so one program per slot and block serves eve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
    [batch_bench.py, batching.py, test_serve_batching.py]
2026-10-11 batch / batching: mixed runs (--mixed, off by default). With fewer decoding requests than MCOLS a step's MXU pass has spare rows; Steps.mixed runs the decoding rows and the oldest prompt's next token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
    [api.py, batching.py, test_batch_steps.py, test_serve_batching.py]
2026-10-11 batching: a request takes a free slot in the block of MCOLS slots holding the most requests (a step runs each block in a run of its own), before the longest prefix (another slot's is copied on the ca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
2026-10-11 docs/serve.md: slots packed into blocks, mixed runs (--mixed, off by default) and the card's arrivals A/B (session 12: default gap p50 / p99 / max 45 / 302 / 345 ms and TTFT 0.30-0.39 s; --mixed 45 /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
2026-10-11 progcache / qual refs: opentpu/serve out of the program cache's key and the references' source hash, as opentpu/host. The API server keeps no program in the cache and computes nothing of a reference,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
    [imgcache.py, progcache.py, refs.py, test_progcache.py]
2026-10-11 asic flow: native OpenROAD-flow-scripts first. ORFS_HOME names a clone with its tools built (checked: env.sh, tools/install/OpenROAD/bin/openroad; a half-built one is an error that says so); run then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
    [flow.py, test_asic_flow.py]
2026-10-11 asic/nangate45/results/small: the reference run of nangate45-small, native ORFS f395e4b6 on main 596d62fa (81 min on 20 cores, 15 GB peak): report.json (flow.py report), ORFS's 6_finish.rpt, the rout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
2026-10-11 docs/asic.md: the card's global routing, measured. The router's congestion report puts nearly all the overflow along the ACT RAM's macro block's inner edge and just past it (x 0.4-1.0 mm, y 0-1.4 mm)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
2026-10-11 imgcache: eviction weighs what a miss would cost again. An entry's header keeps its build's seconds (build_s), and over the size the least recently used go first with each build second per GB countin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
    [imgcache.py, test_imgcache.py]
2026-10-11 imgcache: a write under the free-disk floor drops the entries it outranks. It had been skipped, and over-the-size eviction never ran under the floor: on the card host on 2026-10-11 the image cache he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
    [imgcache.py, test_imgcache.py]
2026-10-11 imgcache: a build's look at the image leaves out the weights' entries. Gemma 4's image keeps the weights (_W), and the cache expanded every dict attribute into its entries: with lazy weights (qwen3.L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
    [imgcache.py, test_imgcache.py]
2026-10-11 imgcache: build seconds weigh an entry of this tree only. An entry's header keeps its tree (src: progcache.source(), what the key holds of the sources); another tree's entry goes by its last use alon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
    [imgcache.py, test_imgcache.py]
2026-10-11 bcu1525: the block design and the DDR4 core through Vivado on the free xcku5p (make ipcheck, omarchy with the UltraScale+ device files installed: bd, its seven IPs synthesized out of context, otpu_ld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
2026-10-11 bcu1525: make synthcheck, the whole project synthesized on another part (scripts/synth_check.tcl: create_project.tcl with OTPU_PART, the real block design and DDR4 cores, the top at S = 2, developmen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
2026-10-12 rtl/exp/tmem_pump (EXPERIMENTAL, in no file list): otpu_tmem_pump, the TMEM with its block RAM copies pumped at twice the core clock. A pumped copy is LANES true dual-port banks on clk_f: at each cor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
2026-10-12 TMEM_RQ: the banked TMEM (TMEM_IMPL 1) with its bank addresses from the requests. otpu_tmem RQ: a copy's bank address is the first asking port's in the slice's priority order (PRANK: DMA, COLL, VPU, 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
    [otpu_board.sv, otpu_native_sys.sv, otpu_slice.sv, otpu_tmem.sv, otpu_tmem_pump.sv, otpu_top.sv, rtlsim.py]
2026-10-12 scoreboard: a hardware configuration's decode, prefill (TTFT), batched decode and MoE, from an analytic model calibrated on the card and the RTL co-sim (tools/scoreboard.py, pure Python, no checkpoin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
    [scoreboard.py, scoreboard_cosim.py]
2026-10-12 otpu_slice: TMEM_NCP, the banked TMEM's copies (3, or 4). Four is the read slots of two pumped copies (rtl/exp/tmem_pump, two reads per core cycle each), to co-sim that TMEM's cycles: MXU and VPU A, 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
2026-10-12 scoreboard: what binds, serial attention, the tile kernel. Every result carries each unit's share of its time (the weight stream named port or memory, MXU, attention, DSTEP, overhead, host link, host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
    [scoreboard.py, test_scoreboard.py]
2026-10-12 A TMEM above 64K words: the sequencer's hazard ranges and STREAM's descriptors. otpu_seq kept an instruction's TMEM ranges in 16 bits (TAW), so any range at or above word 65536 raised all and the ins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
    [compiler.py, otpu_pkg.sv, otpu_seq.sv, otpu_slice.sv, test_stream.py]
2026-10-12 rtl/exp/tmem_pump/run_ooc.sh: the boards' own UltraScale+ parts (vu9-*: xcvu9p-fsgd2104-2L-e, the BCU1525's; vu47-*: xcvu47p-fsvh2892-2-e, AWS F2's), pumped block RAM and UltraRAM at 250 / 500 MHz. o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
2026-10-12 rtl/exp/tmem_pump/run_ooc.sh: k7-v2-150, the pumped TMEM with the core at 150 MHz and its copies at 300 (the margin above the card's 133.33)
2026-10-12 scoreboard: the co-sim campaign and the overhead's form. The campaign (tools/scoreboard_campaign.sh, two slot jobs on hwe-bench, 2026-10-12; tools/scoreboard_cosim_runs.jsonl, validate's "co-sim camp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
    [scoreboard.py, test_scoreboard.py]
2026-10-12 asic/nangate45/openlayout: nangate45-small at 60% utilization and 3.3 ns with OpenLayout's macro placement (#6)
    A second physical-design flow for the ASIC block next to tools/asic/flow.py's ORFS flow: Yosys flat
    synthesis, a 60% floorplan (2.05 x 2.05 mm = 4.20 mm², against the ORFS reference's 7.02 mm² at 35%),
    macro placement planned and checked with OpenLayout's planner / checker skills on pin-side images
    (three candidates against an rtl_macro_placer baseline), OpenROAD place / CTS / route (run.sh,
    scripts/, candidates/).
    cand2 at 3.3 ns: routed, 0 DRC, setup +0.156 ns / hold +0.051 ns on global-route parasitics; on
    OpenRCX-extracted parasitics setup -0.05 ns (31 endpoints, TNS -0.54 n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
2026-10-12 vpu-pump (EXPERIMENTAL): where the VPU binds, and whether pumping or widening it pays (docs/vpu_pump.md). The co-sim upper bounds (tools/vpu_hack.py: timing-only transforms novop / half / comp1 / nos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
    [moe_prefill_cosim.py, perf_qwen.py, tb_vpu_pump.sv, vpu_hack.py, vpu_pump_lane.sv]
2026-10-12 scoreboard: DeltaNet's own VOPs and the stream-MXU gap; LANES 16 has no stream engine
    A DeltaNet layer's further rows now also expose 0.4 of their own VOPs. The VOP count is
    vpu-pump's static inventory: 1.75 a conv channel + 112 a v-head + 1.3 a v-head's value,
    15.7 K a row on the 0.8B and 2B, 22.7 K on the 4B. The gap between the stream and the MXU
    hides 0.24 of itself from the DSTEP + VOP sum, at most half of it. The constants are fitted
    together with the kappas on the campaign's new DeltaNet layers (parts 3 and 4, hwe-bench,
    both exit 0) and on the card.
    The campaign's DeltaNet layers, co-sim against the model:
    - 0.8B at R 4: MCOLS 4 320.0 K / 315 K, MCOLS 8 276.4 K / 264 K (before: 254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
2026-10-12 rtl/exp/tmem_pump: the write stage and the phase in the fast domain (FW, the default). Out of context the pumped TMEM's tightest paths crossed from the core clock into the fast one in a single fast p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
    [otpu_tmem_pump.sv]
2026-10-12 MX MXU, the ISA: MM accumulates one exact integer per output (B = m << (W - dw - da) a group, groups with a negative shift drop) and rounds once in the epilogue, y = rne(rne(i2f(acc) x Sw) x (Sa x 2^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
2026-10-12 tools/synth/ooc_rows.py: the ACT RAM's and the MXU's cost by ROWS (ACT_ROWS: the most rows of one MM) out of context. Vivado synth, place and route of otpu_actram and otpu_mxu at the board's paramete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
2026-10-12 offload: expert-major prefill on the card (session pfB). B = --expert-major against A = today's default (layer-major R = 2 pooled, no layer-ahead), with C = --layer-ahead hint, every arm --idle-parts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
2026-10-12 streamed: expert-major is the MoE prompt's default (docs/offload.md 13.15). Session pfB measured it on the card bit for bit and 1.91 s (Qwen3.5-35B-A3B, 134 rows) / 1.78 s (gemma-4-26B-A4B-it, 124 ro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
2026-10-12 tiled prompt runs: every dense family's prefill through tiled runs at run-time positions, opt-in (prefill.py: the engine's tile_runs, else OTPU_TILE=1; off by default). tiled.compile_tile_run: tile_r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
2026-10-12 otpu_slice: TMEM_NCP 2, 5 and 7, and the TMEM's read demand in simulation (docs/tmem_pump.md). TMEM_NCP 2 is one pumped copy's two read slots (P1): MXU, VPU A, QUANT 2 and COLL share one, DMA, VPU B 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
2026-10-12 docs/mx_mxu.md 5: the MX datapath out of context in Vivado. rtl/exp/mx_mxu's tops through run_ooc.sh (Vivado 2026.1: synthesis, opt, place, phys_opt and route at 133.33 MHz, the pumped columns at 266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
2026-10-12 tiled prompt runs: Gemma 4 (E2B / E4B shapes, per-layer inputs). tiled.gemma4_tile: gemma4_step's rows of a prompt run tiled, its tokens gathered from out[] and the per-layer inputs as gemma4_step's;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
2026-10-12 docs/mx_mxu.md 5: the MX datapath's new paths in Vivado (rtl/exp/mx_mxu/paths.tcl on the routed checkpoints of 2 and 4 columns). 7-series: the column end's shift into the B port +2.351 / +2.143 ns (6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
2026-10-12 rtl/exp/tmem_pump: one copy pumped at 3x or 4x (K), and the write stage's multicycle path found. More fast edges give a copy no more reads at otpu_tmem's latency: a read's word must hold through the 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
2026-10-12 MX column RTL: otpu_mxu and otpu_quant equal the MX ISA (b370889d) bit for bit, replacing the previous datapath (MXU_IMPL must be 2; create_project.tcl and rtlsim refuse the tree MXU). otpu_mxu: the 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
2026-10-12 MX column: CAPS bit29 MX, the numerics in the CFG_HASH, the quantizer's group RAMs sized from the configuration, and a co-sim statistic of the MXU's scale reads. otpu_ctrl's CAPS sets bit29 (MX numer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
    [base_top.sv, otpu_ctrl.sv, otpu_mxu.sv, otpu_slice.sv, perf_qwen.py, regs.py, rtlsim.py, target.py]
2026-10-12 MX column tests: CAPS bit29 in the register-map tests, ACT_ROWS 16 in the MM replay test. tests/test_observability.py: the board model's CAPS reads 0xE7 in its top byte (bit29 MX with WAITW, GEN, STR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
2026-10-12 The card target's ACT RAM holds 16 rows: the MX production build's (tiling and the MX lead: the block-RAM-free maximum, +260 LUT and +72 FF out of context, MMs of up to 16 rows replaying each weight 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
    [fake.py, test_target.py]
2026-10-12 tiled prompt runs: the real models' TMEM (8 to 16 rows a run on every family) and the engine's switch. A compile-only survey of the families' prompt runs at bucket 2 (tools/perf_prompt.py --compile-o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
2026-10-12 docs/tmem_pump.md: the TMEM study, fewer copies, pumped copies and more words. Banked TMEM on the YPCB (b1 misses 133.33 MHz by 3.27 ns, b2 with request-priority addresses by 1.06 ns; 0.0-3.2% in cyc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
2026-10-12 tiled prompt runs: a run over IMEM at the attention's depth takes the same form at depth 2 (tiled.SHALLOW). A tile's program grows with the blocks each packed tile's attention leaves unrolled (_atten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
2026-10-12 tests/test_tiled.py: a tiled expert-major layer run on the RTL (the board's memory path; DRAM and TMEM as the ISA simulator's): the tiny Gemma 4 MoE's sliding layer, 4 rows on the card's ACT RAM of 4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
2026-10-12 docs/tiled_prefill.md 10: the tile in the engine (2026-10-12). What runs tiled per family (dense prompt runs: Qwen3 and the Llama-likes, Qwen3.5, LFM2 / LFM2.5, Gemma 4 E2B / E4B with PLE; MoE expert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
2026-10-12 MX MXU, the software: the packers, the compiler, the kernels, every model family, the emulations, the caches and the tools on the MX numerics of b370889d (docs/isa.md "MM", "Weight formats", "Quantiz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
    [api.py, bench_llm.py, board.py, chat.py, chatkv.py, compare_hf.py, compiler.py, decode_profile.py]
2026-10-12 host: a bitstream without the MX numerics (CAPS bit29) is refused. board.check_numerics raises ConfigMismatch ("the bitstream lacks the MX numerics (CAPS bit29): its MXU and quantizer are the ones be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
2026-10-12 streamed: expert-major by default only with room for its needs. The Mac gate on e42f5eb2 failed 12 of test_chatmoe's chats (qwen35, gemma4: 1403 passed): with 2 slots a layer, a need found "no slot o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
    [streamed.py, test_chatmoe.py, test_qwen35_moe.py]
2026-10-12 docs/quant.md: the MX formats' accuracy, measured on the device's quantization. tools/formats_scan.py ppl (its emulation: the device's quantization points and QACT ranges, the window's drops) on Qwen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
2026-10-12 tests/test_host.py: the fake's register map as this tree's bitstreams report it. test_v3_info_snapshot_and_rates expected CAPS without bit24 and bit29, but FakeTransport now reports the card target's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
2026-10-12 otpu_mxu: past an odd KB, PAIR's high rows read the chunk's even block again, not block ab + KB. A PAIR MM with an odd KB reads its last chunk's high block for the rows of act_hi, block ab + KB, outs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
2026-10-12 tmem-nocopy (EXPERIMENTAL): a simulation model of single-copy TMEMs, the TMEM's access trace, and a longer read path's latency. otpu_slice TMEM_IMPL 2 (simulation only): the data stay in otpu_tmem IM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
2026-10-12 gemma-4-26B-A4B-it's experts in NVFP4 by default: the user's decision (2026-10-12), over the formats rule. On chat text NVFP4 experts gain nothing over fp4x6 (mx-acc's rerun), but they are the more r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
2026-10-12 Token-on-RTL tests for the card families that had none: SmolLM3 and Phi-4-mini (tests/test_llama.py test_tiny_token_on_board_rtl, the tiny models of both, per position and resident: a token after a 3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
2026-10-12 tiled runs under MX: each operand quantized over today's columns, so a tiled run is today's bits again. MX's QACT gives each row one Sa over the blocks it writes, and an MM reads the blocks of one Sa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
    [perf_prompt.py, test_tiled.py]
2026-10-12 tiled runs under MX: the operands quantized whole let their TMEM go (quantize(free=True)). A stationary keeps its source tile alive unless free: the [T, C] activation tile of every down chunk stayed 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
2026-10-12 test_fp_rtl: the -0 MM test in MX terms. test_mm_partials_flushed_to_minus_zero_rtl pinned the previous numerics (per-block fp32 weight scales whose partial sums flush to -0, no +0 pad term in isum_4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
    [test_fp_rtl.py]
2026-10-12 seq_vpu (EXPERIMENTAL): otpu_seq's simulation-only hazard-check emulations and statistics (+hz_* plusargs, defaults unchanged, nothing synthesized): granules and hulls of the TMEM / DRAM ranges (a ch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
2026-10-12 seq_vpu (EXPERIMENTAL): otpu_vpu's simulation-only rate knobs (+vt_ew / +vt_comp: an elementwise / composite chunk issues on one enabled cycle in N, a path 1/N as wide at today's latency; +vt_red: a 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
    [otpu_vpu.sv]
2026-10-12 seq_vpu (EXPERIMENTAL): +hz_kclamp (wait counts with fewer bits), +hz_kc (the oracle on coarse footprints), KOUT=x / WC=x oracle files, their candidates
2026-10-12 seq_vpu (EXPERIMENTAL): otpu_seq WAITC, the explicit-dependency finalist (default 0, the card's build unchanged): no footprints, no range compares, the footprint stages skipped (R -> P -> C); a sidec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
    [otpu_seq.sv, otpu_slice.sv, otpu_top.sv, rtlsim.py, tb_top.sv]
2026-10-12 tmem-nocopy (EXPERIMENTAL): replays (otpu_tmem IMPL 3 RPL, otpu_slice TMEM_RPL), the hashed sub-bank (SBH), and the out-of-context top. With RPL the slice keeps the board's arbiter (ARB_MASK: write b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
2026-10-12 seq_vpu (EXPERIMENTAL): run_ooc.sh / ooc.tcl take another part and period (OTPU_PART, OTPU_PERIOD), for the UltraScale+ boards' stand-in
2026-10-12 tmem-nocopy (EXPERIMENTAL): otpu_tmem RPL's premise checked in simulation (a write landing on a word whose replay is still pending, while the replay loses again, stops the simulation: the replay woul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
2026-10-12 waits (EXPERIMENTAL, docs/seq_vpu.md): the compiler's wait counts for otpu_seq WAITC, from the program alone. opentpu/waits.py: an abstract execution of the program (registers as intervals; the run's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
    [isasim.py, rtlsim.py, test_waits.py, waits.py]
2026-10-12 tmem-nocopy (EXPERIMENTAL): the reads' producers (tools/tmem_trace.py flow), fewer readers and a split true dual-port copy in the grant model. tmem_trace.py flow: per read port, the words read, the s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
2026-10-12 tiled runs under MX: the attention's outputs whole through an I/O scratch. The whole forms gathered the outputs [T, n_q d] in TMEM while the heads attended: 16-32K words that cost rows (Qwen3.5's tin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
2026-10-12 tmem-nocopy (EXPERIMENTAL): the replay TMEM on true dual-port RAMs (otpu_tmem TDP, otpu_slice TMEM_TDP), and one asker a port. TDP: each RAM's two ports, every read port on one of them (SIDE; the sli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
    [otpu_slice.sv, otpu_tmem.sv, otpu_top.sv, rtlsim.py, tb_tmem.sv, tb_top.sv, test_rtl.py, tmem_nc_top.sv]
2026-10-12 tools/validate.py: the golden's projections drop what MM's window drops. A group of D/8 columns whose input offset da and weight offset dw add up to more than the format's window W (int8 16, fp4 / in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
    [test_validate.py, validate.py]
2026-10-12 tmem-nocopy (EXPERIMENTAL): P3 in the one-copy TMEM's out-of-context harness, the LUT breakdown's ablations, and fewer RAMs a bank on true dual-port RAMs. tmem_nc_top VAR 6: P3 (rtl/exp/tmem_pump/otp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
2026-10-12 seq_vpu (EXPERIMENTAL): WAITC v2, the VPU's producers as a mask. With every unit in order on the compiler's counts (wcc) WAITC cost +4.2% on the resident decode and +5% / +8.7% on prefill (p_q3 / p8_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
2026-10-12 tmem-nocopy (EXPERIMENTAL): QUANT 3 and COLL the DMA's guests in the one-copy TMEM (otpu_tmem GST, otpu_slice TMEM_GST), as in today's TMEM. A guest reads only while SH_HOST and the guests before it 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
    [otpu_slice.sv, otpu_tmem.sv, otpu_top.sv, rtlsim.py, tb_tmem.sv, tb_top.sv, test_rtl.py, tmem_nc_top.sv]
2026-10-12 streamed: expert-major from EM_ROWS new rows a call (docs/offload.md 13.16). Session emdef (the lead's, 2026-10-12 10:17-10:33) ran 950ff0c5's default on the card, token-exact, but the 35B's short tu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
    [chatmoe.py, moe_card.py, streamed.py, test_chatmoe.py]
2026-10-12 tmem-nocopy (EXPERIMENTAL): one copy pumped at 2x with replays (otpu_tmem PMP, otpu_slice TMEM_PMP), and one RAM a bank (NSB 1). PMP 1 (with TDP): each RAM is P3's pumped bank (otpu_pump_bank on clk_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
2026-10-12 seq_vpu (EXPERIMENTAL): otpu_seq simulation knobs that split WAITC v2's cost: +wc_vx=1 takes a slot's VPU producers from today's range check (fp_seg, conf_s) instead of its mask, +wc_vgate=G holds a 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
2026-10-12 seq_vpu (EXPERIMENTAL): WAITC needs WIN <= 16 (4-bit counts and the 15-bit VPU mask name a unit's last 15; an in-order unit's 16th last has completed only with a window of 16, the card's): rtlsim rai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
2026-10-12 tiled runs: the whole forms placed next-fit. Their load back of the attention's outputs needs [T, n_q d] words in one piece once the heads are done (Qwen3-0.6B at 16 rows: 32K of the 64K-word TMEM), 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
    [test_tiled.py]
2026-10-12 MXU: the card builds 4 epilogue lanes (E = MCOLS, full rate). targets/ypcb-00338.toml [uarch] MXU_E = 4 flows through opentpu/target.py (rtl_params; sim_uarch, so rtlsim.BOARD_UARCH and T_MXU_E carry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
2026-10-12 Tiled prompt runs on by default. prefill.tile_flag: OTPU_TILE unset (or empty) is on, OTPU_TILE=0 off, an engine's tile_runs saying either first; an engine with prompt runs then grows its image's I/O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
2026-10-12 Tiled prompt runs by default: one slice only, and the tests of today's runs say so. With the default on, a design configuration's engine (two slices) took tiled runs and failed in tiled.check ("tiled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
    [test_prefill.py, test_prefill_gemma4.py, test_tiled.py]
2026-10-12 WAITC production flip (EXPERIMENTAL, off by default): SEQ_WC is a Config field and an [arch] key of every target (false everywhere), through otpu_board to the slices and otpu_ctrl's CFG_UARCH bit24; 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
    RTL and flows: SEQ_WC through the tops (otpu_fpga_top_ld / otpu_native_sys, otpu_fpga_top_bcu / otpu_bcu_sys, tb_board) to otpu_board, both slices and otpu_ctrl (CFG_UARCH [24]); run_vivado.sh's SEQ_WC knob (the target's, or SEQ_WC=1) reaches create_project.tcl's generics and the CFG_HASH (python3 -m opentpu.target hash ... SEQ_WC=). target.arch_h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
    [board.py, checks.py, compiler.py, diag.py, fake.py, hwlens.py]
2026-10-12 streamed: EM_ROWS 44 for Qwen3.5 from session emdef2's crossover; chatmoe.py records the host's time and runs on production's tree (docs/offload.md 13.16). emdef2 (the lead's, 2026-10-12 11:39-12:03 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
    [chatmoe.py, streamed.py, test_chatmoe.py]
2026-10-12 WAITC (EXPERIMENTAL): the waits pass off the critical path. On a configuration whose sequencer takes wait entries (SEQ_WC) the compile worker processes compute a program's entries with its words (qwe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
2026-10-12 YPCB build: TRACE_DEPTH as a build knob (run_vivado.sh TRACE_DEPTH=0 leaves the trace buffer out: CAPS trace bit 0, 32 RAMB36, ~2.3K LUT, ~3.9K FF; default the target's 16384, the netlist unchanged),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
2026-10-12 otpu_mem_ch: the read tags' FIFO per port sized from the reads in flight (TGD = the power of two at or above ARD + XRD + 1: 128 at the board's ARD 64 / XRD 16, as before), replacing the fatal on ARD 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
2026-10-12 docs/tiled_prefill.md 11: the tile under MX, measured, and on by default. 11 (rewritten): each operand quantized over today's columns, the attention's outputs whole through the I/O scratch (5e0eaa08)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
2026-10-12 tmem-nocopy (EXPERIMENTAL): the pumped one copy's RAM sides from the screen, the read ports' ranks and sides as knobs, and each read port's replays counted. otpu_slice TMEMSTAT (simulation only) now 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
2026-10-12 tools/dataflow.py: the data-movement ledger. An instrumented ISA run (isasim.Slice with counters) of a compiled case on a zero image counts, per instruction class and per source site: DRAM bytes by k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
    [dataflow.py]
2026-10-12 WAITC (EXPERIMENTAL): the tests that load a program past the host's load path give a WAITC configuration its wait entries. The omarchy gate with OTPU_SEQ_WC=1 failed seven of test_board's tests on a9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
    [test_autodecode.py, test_board.py, test_waitw_rtl.py]
2026-10-12 docs/tiled_prefill.md 11.2: the tile's bytes a row by level, from dataflow's ledger (tools/dataflow.py at 46609834, the ISA simulator on a zero image, the runs of the cycles table). DRAM a row falls 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
2026-10-12 The tiled runs' I/O scratch only where a tiled run may use it. 5e0eaa08 gave every family's image io "o" (ACT_ROWS x n_q d words), MoE images too, whose layout and expert slots then moved with no til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
    [test_tiled.py]
2026-10-12 otpu_mxu / otpu_actram: the ACT RAM's read enables follow the MM's columns. act_ren was 1'b1: every column's block RAMs (MCOLS x the D-byte pieces and the 8-byte scale record) read every cycle, poppi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
    [otpu_actram.sv, otpu_mxu.sv, otpu_slice.sv, rtlsim.py, test_rtl.py]
2026-10-12 docs/tiled_prefill.md 11.2: the ACT RAM writes a row the tile saves are PAIR's DUP in today's 2-row runs (each row of a 4-bit operand written twice at M <= MCOLS / 2): Qwen3.5-4B 187 KB a row at 2 ro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
2026-10-12 tmem-nocopy: the pumped one copy's 2x clock from the MMCM to the TMEM, and the TMEM's knobs on both boards. clk_f (2 x clk, rising with it) now runs from both board tops through otpu_native_sys / otp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
    [otpu_asic_top.sv, otpu_bcu_sys.sv, otpu_bd_ld_wrapper_stub.sv, otpu_bd_wrapper_stub.sv, otpu_board.sv, otpu_fpga_top_bcu.sv, otpu_native_sys.sv]
2026-10-12 docs: the 2x clock's even divider and the merge notes. docs/board.md: make bit TMEM_IMPL=3 (one TMEM copy pumped on core_clk2x) and core_clk2x in the clock table, with the rule that core_clk's MMCM d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
2026-10-12 formats_scan: the LFM2-MoE and Qwen3.5-MoE models, and MM's window drops counted per variant. ppl / emulate took dense models only ("formats_scan: dense models only"), so the MoE models' production f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
2026-10-12 docs/mx_mxu.md 3.7: the production finals. Every card model at 2000 tokens in its production configuration on the MX column as mx-column 3095bb02 sets it (formats.MIXES, streamed.FORMATS with the 26B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
2026-10-12 WAITC (EXPERIMENTAL): a 31-bit VPU mask, the hold at 31. otpu_seq dispatches a VOP once the VOP 31 before it has completed (was 15), and the wait entry's mask names the VOPs 1..31 back (vmask = w1[30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
2026-10-12 docs/infra_hunt.md: the infrastructure study outside the MXU, TMEM and the sequencer / VPU (91a9c2d3 on xc7k480t-2 at 133.33 MHz; xcku5p-2 alongside), with the lead's decisions of 2026-10-12. The mem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
2026-10-12 docs/mx_mxu.md 9: the MX production build, 8b33206e. Its column in the board-build table (133.33 MHz, DDR3-1066, E 4, the QACT row buffer at XD 1024: WNS +0.007, WHS +0.013, LUT 178,529, FF 138,466, 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
2026-10-12 test_mtp: the stop cases stop at the second of the first accepted pair whose token is new to the ones before, not always at the third token. test_mtp_sampled_loop_is_plain_sampling[252-right-pen-15-T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
    [test_mtp.py]
2026-10-12 docs/mx_mxu.md 10: MCOLS 16 on the YPCB, out of context. Section 5's experiment at eight pumped DSP48E1 columns (16 rows, mx_top on otpu_mx_x7, xc7k480t-2, clk_s 133.33 / clk_f 266.67 MHz): E 4 29,40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
2026-10-12 docs/mx_mxu.md 10: what the ACT RAM's 272 RAMB36 at MCOLS 16 hold. One copy of distinct rows (row r only in column r mod MCOLS), 256 KiB of int8 and 16 KiB of scale records at ACT_ROWS 16 for MCOLS 4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
2026-10-12 docs/mx_mxu.md 10: ACT_ROWS 64's weight bytes and its limit. From dataflow's ledger (fp4x6 layers, one pass's layer weights over the rows): Qwen3-0.6B 14.9 -> 3.7 MB a prompt row from 16 to 64 rows, 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
2026-10-12 docs/tmem_nocopy.md 6.6: the fewer-consumers lever measured with feedback. dataflow's co-simulation (docs/dataflow.md 5.3) of the pick (r2pgRs, b5d6bcef) against today's TMEM on Qwen3-0.6B, 2 layers,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
2026-10-12 tools: the fold's bounds by stage, the tile kernel's roles, and the KV cache formats under test. tools/dataflow.py: role() knows the tile kernel's sites (tiled._norm_quantize: norm statistics, _add_p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
2026-10-12 docs/mx_mxu.md 9: MX in production. deploy_mx_8b33206e (build 8b33206e, host e37709e1) promoted on the card host on 2026-10-12 at 17:49 after its qualification: selftest all pass at Gen2 x8, qual.sh 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
2026-10-12 docs/tmem_nocopy.md: the ASIC form measured (job L), first in 6.4. Two-port macros at the core clock (TMEM_TDP without TMEM_PMP: a write takes port A), 2 a bank, replays, guests, on the screen agains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
2026-10-12 tools/moe_prefill_cosim.py em: expert-major's expert run in the RTL co-sim with the server's words (docs/offload.md 13.11). compile_expert_run of one MoE layer (the prefix's last) on a chunk of `rows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
2026-10-12 tools/moe_prefill_cosim.py em: the expert run's DRAM bytes by kind and a row, and layer-major's passes on the same ids. em_bytes, in whole 64-byte lines: each pass streams its expert, reads its two r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
2026-10-12 docs/offload.md: emdef4 and production, and the expert run in the co-sim (13.13, 13.16, 13.17). emdef4 (the lead's, 2026-10-12, 7f815b57, the balanced order, four pairs): token-exact, all passed; N -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
2026-10-12 Expert-major's pass row capacity on the router traces (docs/offload.md 13.17). tools/offload/em_capacity.py: on offload's router traces (four texts x 2048 tokens, every MoE layer's top-k), every non-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
2026-10-12 test_perf: attention decode's roofline at the epilogue the card builds, E = MCOLS, and the half-rate epilogue's limit kept as a strict xfail. test_attention_decode_at_roofline[6-1-2048] failed in the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
    [test_perf.py]
2026-10-12 Expert-major passes of C entries, C from the configuration (docs/offload.md 13.18). moe.moe_expert_run(..., C, S): the bucketing closes a pass at C entries of one expert (a pass table row of C + 2 wo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
    [chatmoe.py, moe_prefill_cosim.py, streamed.py, test_gemma4_moe.py]
2026-10-12 WAITC (EXPERIMENTAL): the omarchy gate's board-model failures with OTPU_SEQ_WC=1 (gate_boardwc on 8140ce7a's tree, 38a6342b's code: 3 failed, 150 passed), both in the tests. test_bar_and_gather_acros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
    [test_board.py]
2026-10-12 WAITC (EXPERIMENTAL): an RLD's bound, the open compiler item of docs/seq_vpu.md 4.5. The waits pass took every RLD value as unknown, so each footprint computed from such a register covered its whole 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
    [compiler.py, isa.py, isasim.py, offload.py]
2026-10-12 test_expert_major_prefill_is_bit_exact: the configuration's C is 8 for int8 at the default MCOLS 8 (no PAIR: int8 takes a chunk a cycle for up to MCOLS rows), 4 with build B's MCOLS 4 and PAIR. The a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
    [test_qwen35_moe.py]
2026-10-12 docs/offload.md 13.18: C = 4 on the card, in the co-sim and where the time goes; the slots expert-major leaves. emc1 (the lead's, 2026-10-12, MX production 8b33206e, host e7c65617; A --em-pass 2, B C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
    [em_slotsim.py]
2026-10-12 docs/offload.md 13.18: the next steps, deferred past r2 (branch emc2, nothing built). The slots expert-major leaves: from the server's code the cause is not the expert run's pass order but ExpertServ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
2026-10-12 docs/seq_vpu.md: the RLD bounds' result (section 4.5, hwe-bench job R, simulated): on the 35B's layer programs 13 of 14 RLDs bounded, the VPU masks' bits 1,473 -> 985 and 1,570 -> 1,064, no loop of u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
2026-10-12 docs/dataflow.md: where the bytes go, and folding the VPU into the MXU. The study's answer to "can we fold the VPU into the MXU without compromising decode or prefill, and what would it gain". The le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
    [dataflow.py]
2026-10-12 docs/mx_mxu.md 10: the 2x clock's MX section is a next-release item. r2 builds an unpumped MXU (MCOLS 8, E 8), so the pumped PEs' multicycle in otpu_clk2x.tcl waits for the release that pumps the col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
2026-10-13 release-2: the release configuration. targets/ypcb-00338.toml: MCOLS 8 and MXU_E 8 (docs/mx_mxu.md 9: E = MCOLS at MCOLS 8), SEQ_WC true (WAITC v2), TMEM_IMPL 3 with the pick r2pgRs as uarch keys (TM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
2026-10-13 release-2 tests: the card's target is r2's (MCOLS 8, SEQ_WC, TMEM_IMPL 3). hwe-bench gate R2 on 4b018ac2 failed 7 tests, all on the previous configuration's constants: test_target's board_config / ar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
    [test_observability.py, test_target.py, test_waits.py]
2026-10-13 rtlsim, board model: TMEM_IMPL 3's sub-bank bit above a LANES 16 configuration's lane banks. The r2 target sets no TMEM_SBP, so otpu_tmem's default 3 (LANES 8's) reached LANES 16 runs and its check (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
    [board.py, rtlsim.py, test_rtl.py]
2026-10-13 tests: test_tiled_expert_major_layer_run_on_rtl's 4-row cases on an MCOLS 4 card. The ACT RAM's rows are a multiple of MCOLS, and board_config's MCOLS is the target's, 8 since r2 (4b018ac2): ACT_ROWS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
2026-10-13 ypcb-00338: the MXU's systolic array placed as a grid (constraints/otpu_mxu_place.tcl). r2's MCOLS 8 dev build f55949f9 did not route (global congestion level 6, the router's estimate South level 7; 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
2026-10-13 otpu_mxu_place.tcl: its record only in an implementation run's directory (or OTPU_MXU_PLACE_XDC). build.tcl opens the synthesized design for its reports, which reads the constraint too, and the recor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
2026-10-13 create_project.tcl: BUILD_ID and ARCH_HASH read as given. The arguments went through expr's ?:, which reads a numeric-looking string as a number: dev build 83740e79's BUILD_ID came out 8.374e+83, fai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
2026-10-13 otpu_tmem / otpu_slice: the single pumped TMEM copy's replays make progress (release r2's hang). Under the r2 target (OTPU_UARCH=board), test_fuzz_mm_replay[2-8-1] and [2-6-3] never halted. QUANT hel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
2026-10-13 release-2: the Mac gate's MCOLS 8 failures. otpu-diag's read-only register check took MCOLS 2 or 4 alone, and failed the r2 card's VERSION 0x800808 (MCOLS 8; test_diag_sim_registers_and_memory_pass);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
    [diag.py, test_host.py, test_prefill.py]
2026-10-13 release-2: 128K TMEM words (targets/ypcb-00338.toml TMEM_WORDS 131072; CFG_HASH 46b96e6d, 64K's 19a2400e). At MCOLS 8 and 64K, Qwen3.5's MTP prompt runs held 4-7 rows and Gemma 4 E2B's 4-6, next-fit 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
    [otpu_native_sys.sv, target.py, test_rtl.py, test_target.py, test_waits.py]
2026-10-13 board model: the target's TMEM words. BoardModel built tb_board from board_config() without TMEM_WORDS (tb_board's default 64K) and its CFG_HASH without it, so with the r2 target's 128K the board-mod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
2026-10-13 targets: variants. A target file's [variants.<name>] tables hold arch and uarch values over the file's, selected as NAME:VARIANT (OTPU_TARGET, run_vivado.sh / make bit TARGET), the file's [target] va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
2026-10-13 prefill: a bucket takes the prompt-run form with more rows a run, tiled on a tie. Tiling took every bucket a tile fits, also where the tile takes fewer rows than today's prompt runs: LFM2-2.6B fp4's 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
2026-10-13 rtl: TMEM's input stage, the sequencer's wait test registered, and the card's collective unit without GATHER (release r2's timing fixes for r2m4's failing groups). r2's m4 build (r2m4_d352e53d, 133.3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
    The input stage (docs/tmem_nocopy.md 7.1): every TMEM read request goes from flip-flops, a cycle after it forms (MXU t_ren with t_gnt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
    [board.py, otpu_board.sv, otpu_coll.sv, otpu_dma.sv, otpu_mxu.sv, otpu_quant.sv, otpu_seq.sv, otpu_slice.sv]
2026-10-13 boards/ypcb-00338: the MXU's grid by default at MCOLS 8 and up only. otpu_mxu_place.tcl decides from the netlist's MCOLS: below 8 it leaves the array to the placer and says "otpu_mxu_place: off (MCOL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
2026-10-13 tests: test_ldc_memory_path's programs gather where the board's collective unit does. It runs the board's uarch (rtlsim.BOARD_UARCH: the card's one slice, BAR alone since 9eba263e) whatever uarch the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
2026-10-13 tests: test_op_check_on_board_model runs GATHER's check where the simulated collective unit has it (rtlsim.gathers), as otpu-diag takes it from CAPS2 (diag.py: the card's, BAR alone, skips it). Under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
    [test_board.py]
2026-10-13 tests: the board model's tests take SEQ_WC from the uarch the session simulates. conftest.sim_board_config: isasim.board_config with SEQ_WC (the sequencer's wait entries, CFG_UARCH bit24) where rtlsi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
    [test_board.py, test_observability.py]
2026-10-13 rtl/dma: the TMEM read request straight from flip-flops (WIP, r2-dma-adv: adv predicted a cycle ahead; untested)
    [otpu_dma.sv]
2026-10-13 boards/ypcb-00338: the memory PHY's OSERDES data flops in pblocks beside their pads (otpu_ddr_phy_place.tcl, late, on the linked netlist). Each flop driving an OSERDESE2 / OSERDESE3 data or tristate 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
2026-10-13 otpu_slice: SW_REG, the SW port (QST writes) from a register for the ASIC block
    The quantizer's scalar write port left the slice combinationally: sw_wdata from the
    QST scale-row word (the group maxes through dval) and sw_req from the TMEM grant. On
    the nangate45-small block at 3.0 ns these were the only setup violators after
    routing (21 endpoints, worst -0.698 ns on sw_wdata[25] with the virtual I/O clock
    ideal).
    SW_REG (otpu_slice parameter, default 0) puts sw_req / sw_addr / sw_wdata / sw_be
    behind flip-flops:
    - the register takes a write when empty or draining this cycle; the arbiters see
    sw_rdy_i = !sw_v || sw_rdy, so the quantizer's grant is withheld exactly when the
    port cannot ta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
    [flow.py, otpu_asic_top.sv, otpu_slice.sv, otpu_top.sv, rtlsim.py, target.py, tb_top.sv]
2026-10-13 docs/asic_timing_loop.md: the macro placements and the routed layout
    The two macro-placement candidates as the checker saw them (pin sides, I/O pin
    groups) and candA routed in iteration 1, downscaled (docs/img, 46 + 46 + 427 KB).
2026-10-13 tests: test_mxu_starve_counter's DRAM_WAIT at the short latency near 0, not 0. Under the card's uarch (OTPU_UARCH=board: r2's TMEM input stage and the registered wait release) the MLP kernel at +axi_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
    [test_observability.py]
2026-10-13 tools/litedram, boards/ypcb-00338/litedram: the sys clock's three route families get a hop each. r2's builds at 133.33 MHz left the LiteDRAM core's sys clock at +0.019 to +0.055 ns on ld-fmax's famil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
2026-10-13 boards/ypcb-00338/constraints/otpu_mxu_place.tcl: the MXU grid's column ends in the middle of their columns. Each chain's last DSP feeds its own DSP of the column end (otpu_mxce g_m[g]) from its P re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
2026-10-13 boards/ypcb-00338/constraints/otpu_mxu_place.tcl: the MXU's weight RAMs level with the positions they feed. Through wsel each g_fd RAM's bits reach two position ranges, an 8-bit format's and a 4-bit 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
2026-10-13 asic: the card point is release r2's card (m4). targets/nangate45.toml takes the card's configuration (ACT_ROWS 16, SEQ_WC, MXU_E 4, 64K TMEM words: the card's CFG_HASH 4ffd1e17) and r2's one TMEM co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
    [fakeram.py, flow.py, otpu_asic_top.sv, otpu_tech_ram.sv, otpu_tmem.sv, paths.py, tb_tech_ram.sv, test_asic_flow.py]
2026-10-13 asic: the card point on a smaller die. flow.py's points take global placement's density margin (addon: PLACE_DENSITY_LB_ADDON, 0.10 unless stated) and 'flow.py config POINT' writes config.mk and the 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
2026-10-13 waits: the wait analysis 2-5 times faster, with the same entries (_MemoPass, wait_counts' default). - The pass visits every instruction a run executes. MiniCPM-V's tower attention at 1,024 patches is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
2026-10-13 minicpmv: MiniCPM-V 4.7's language model loads as qwen35's MoE (docs/minicpmv.md 4.1). load_spec takes model_type minicpmv4_7 to qwen35.Spec.from_hf (its text_config); MODELS' minicpmv-35b is MiniCPM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
    [test_minicpmv.py]
2026-10-13 minicpmv: the vision side's validation against HF (docs/minicpmv.md 5) and per-kind vision formats. VisionImage.formats: the tower's MXU formats by kind (attn, mlp, wm: the window merger's MLP, proj,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
2026-10-13 minicpmv: the model's image with the vision side, image rows in the layer-major prefill, M-RoPE rows written by the host (docs/minicpmv.md 4.3, 4.4). opentpu/llm/minicpmv.py: Spec (qwen35's Spec with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
2026-10-13 minicpmv: images in otpu-chat and otpu-serve (docs/minicpmv.md 4.4). opentpu/host/chat.py: Chat.attach (an image for the next message: a path, data: URL, base64 or PIL), the message's images before i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
    [api.py, chat.py, scheduler.py, test_minicpmv.py]
2026-10-13 docs: minicpmv.md 4-7 as built (the card's window order, the vision layout and kernels, image rows and the host's M-RoPE rows, approved by the lead 2026-10-13, otpu-chat and otpu-serve images, the ho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
2026-10-13 minicpmv: the vision weights in slot-sized pieces, their addresses from a table (docs/minicpmv.md 4.2, the staged vision side's first step). opentpu/kernels/pieces.py: a matrix's rows (whole units: a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
2026-10-13 minicpmv: the vision weights staged through the expert server (docs/minicpmv.md 4.2, 5.3; the lead's choice, 2026-10-13). Spec.vision_staged: the tower's pieces (446 at the real dims, 763.6 MB) are t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
2026-10-13 minicpmv: its own weight formats on the card, the 35B's mix with DeltaNet int8 in layers 0-19 and the shared expert int8 (docs/minicpmv.md 5.1, 7). streamed.FORMATS["minicpmv"] = fp4 experts, int8 he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
2026-10-13 docs/minicpmv.md 6: the card host's files (img/, refs/, pylib/: torchvision, pillow and transformers 5.18 over the venv, without which the image's resize is not HF's processor's) and session mcpv1 (t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
2026-10-13 docs/minicpmv.md 5.2: the 0.776 row diagnosed. One row of 203 (cats.jpg's second crop, output row 68, its bottom edge). Stage by stage on the ISA simulator (hwe-bench): every row >= 0.998 through lay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
2026-10-13 tools/minicpmv_tower.py: where a MiniCPM-V image's seconds go, and the tower co-simulated. time: the engine as chatmoe.py opens it, then per image the host's preprocessing (minicpmv.prepare), each cr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
2026-10-13 tests/test_minicpmv.py: staged vision with its pieces in a pool file. test_staged_vision_is_the_resident_towers also runs with the engine's pool file (the split format, each entry packed on its first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
2026-10-13 tools/offload/sessions/mcpv2.sh: card session mcpv2 (docs/minicpmv.md 6), where MiniCPM-V's time goes and the staged vision. tower: tools/minicpmv_tower.py time on cats.jpg (one crop) and doc.png (7 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
2026-10-13 docs/minicpmv.md: sessions mcpv1 and mcpv2, and the reply's dKL. mcpv1 passed (text, thumb, serve token-exact). mcpv2 passed (tower, text, staged, stower; sliced waits for its reference). - The tower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
2026-10-13 opentpu/host/vision_warm.py: MiniCPM-V's tower programs' wait entries computed ahead of its first images (docs/minicpmv.md 6; the lead's (b), 2026-10-13). - The problem: on a WAITC card, BoardBackend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
    [chatmoe.py, minicpmv_tower.py, streamed.py, test_minicpmv.py, vision_warm.py]
2026-10-13 minicpmv: staged vision is the default (the lead's decision, 2026-10-13, after session mcpv2: decode +8.4%, -14% MB a token, an image +0.3-0.9 s). - Spec.vision_staged defaults to True, for a MoE's i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
2026-10-13 minicpmv: the tower's wait entries, memoized against exact, and the analysis in the doc (docs/minicpmv.md 6; the pass is dbfd2090, waits: _MemoPass). - tests/test_minicpmv.py test_the_towers_wait_ent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
2026-10-13 tools/offload/pool_disk.py and session mcpv3 (docs/minicpmv.md 6). pool_disk.py: what the expert pool's disk costs a warm process. - The engine opens as otpu-chat's and a turn warms it; the open's re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
    [pool_disk.py]
2026-10-13 tools/minicpmv_tower.py cosim --profile: the activity windows' sums (MXU pops, TMEM arbitration lost by the drain / QUANT / VPU, port waits, the MXU starved or blocked) and the MMs by shape with the 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
    [minicpmv_tower.py]
2026-10-13 tests/test_minicpmv.py: the tower's drain-rate test through compiler.slow_drains (conftest assert_drains_keep_up, main 7ecc91d6) instead of its own bank count; it fails on the residual at its DRAM st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
    [test_minicpmv.py]
2026-10-13 minicpmv: staged vision's room checked on an engine's image, not in every image's constructor (session mcpv3's first run, 2026-10-13: FAILED in 3 minutes, host-side, every run at the engine's open: "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
    [streamed.py, test_minicpmv.py]
2026-10-14 pool_disk.py: the dropped arm drops the pool from the page cache, and every arm is checked (session mcpv3b, 2026-10-13: both dropped arms reported the pool's 18.28 GB still in the page cache). The en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
2026-10-14 Session pooldisk: what an expert pool's disk costs a warm process, on the card host's two disks (the lead's GO, 2026-10-13, after mcpv3b's invalid dropped arms). tools/offload/sessions/pooldisk.sh: M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
    [pool_disk.py]
2026-10-14 docs/minicpmv.md 6: session pooldisk's results (2026-10-13 20:20 opentpu, tree c20e4ea6, PASSED: every arm mincore-valid, q35's files unchanged). Warm, the disk does not matter: a miss 0.52-0.63 ms o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
2026-10-14 otpu-serve: /health says 503 "warming" while a streamed MoE's expert pool is read into the page cache, and the engine reads in again what an image's build took out of it (the lead's GO, 2026-10-13, a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
2026-10-14 tools/prefill_routes.py: the route and rows of a dense model's prompt on the card, bucket by bucket, from prefill.py's own rules on a weightless image of the whole model (an Engine as otpu-chat makes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
2026-10-14 serve_bench: a 503 "warming" is a server up, waited for past --wait (882b008f's /health: a streamed MoE's expert pool read into the page cache, ended by the server's --warm-cap). wait_up: /health 200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
2026-10-14 tests/test_target.py: the slice reads the DRAM's writes through the SW register. With SW_REG a QST write can sit a cycle in the SW port's register, in neither the quantizer nor the DRAM, so otpu_slic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
2026-10-14 asic: the card point at ACT_ROWS 8 with the MXU's macros by its columns. targets/nangate45.toml takes ACT_ROWS 8 (the lead's decision on docs/asic.md "ACT_ROWS": 16 rows are 2.06 mm2 of macros here, 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
2026-10-14 pack_pool: the experts' key alone (les's note, 2026-10-13). On MiniCPM-V, whose image stages its vision by default, pool_key carries "vision" (staged vision's entries past the experts), and init and 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
2026-10-14 tools/qual/chatmoe.py: the pool's page cache beside each turn's numbers. r2.1's m8 qual (2343d61e, 2026-10-13) read the Qwen3.5-35B-A3B's 20-row prompt call 11x slower than production's (device 40.5 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
2026-10-14 tools/qual/qual.sh: ECC_EACH=1, the ECC counters after every step. r2.1's m8 2343d61e counted 2 corrected words on channel 0 in its qual fast and none in the 2.5 h after (E2B's qual, the chats, the s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
2026-10-14 qwen35: a unit's DeltaNet layers in a loop inside the unit's loop (prefill programs). Qwen3.5's stack is (3 DeltaNet layers, 1 attention layer) x n: plan's loop over the unit unrolled its three Delta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
2026-10-14 tests/test_minicpmv.py: test_serve_takes_image_url_parts skips without pillow (pytest.importorskip, as the suite does for torch and transformers): hwe-bench's venv has none, and host-r21's gate there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
    [test_minicpmv.py]
2026-10-14 asic: fakeram's read outputs drive like a BUF_X4. A compiled SRAM's output delay grows with its load; fakeram45's (and ours, after it) was a scalar clk->q with a 500 fF limit and a 0.227 ns transitio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
2026-10-14 tiled: LFM2's stack in one loop over its layers (compiler.Counter). LFM2-2.6B's 30 layers (ccA ccA cccA x 4 ccA ccA cc) repeat no unit long enough for plan, so its whole-model tile unrolled nearly ev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
2026-10-14 hostr21.sh: PART B's otpu-serve is stopped with its whole process tree, and the session waits for /dev/xdma0 to close (session hostr21, 2026-10-14: `cd /tmp && env ... timeout ... &` made $! a subshe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
2026-10-14 docs/offload.md 15, tools/offload/lesim.py: lookahead expert scheduling (OpenBMB's LES, asked for MiniCPM-V 4.7 = Qwen3.5-35B-A3B's backbone), measured offline; its prefetch closed, its resident-firs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
2026-10-14 tools/offload/sessions/les1.sh: card session les1 (docs/offload.md 15.4), production's host (deploy_r2m4_b10245f5/host, d8fe2c15) against les's on production's bitstream b10245f5: the 35B and the 26B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
2026-10-14 docs/offload.md 15.6, tools/offload/mtp_bound.py, mtp_transplant.py: a k = 1 MTP loop on the streamed 35B, bounded, and the base's MTP head on MiniCPM-V. mtp_bound.py: lesim's card timeline (session 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
2026-10-14 tests/test_mtp_moe.py: the sampled MTP loop on the card on the streamed MoE gives plain sampled decode's tokens for the same uniforms (drafts all right with the penalty counting row 1's draft, mixed 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
2026-10-14 MoE MTP in the layer-major / expert-major prefill (docs/mtp.md 12): Engine.prefill_layers(mtp=, slot=). mtp: the token after each prompt row (None from the first whose next is not known, the last row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
2026-10-14 pack_pool.py extend: a source pool with entries after its experts (MiniCPM-V's staged vision pieces at layers * E + i, minicpmv 3058195b) gives its experts and their marks only; the written key has n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
2026-10-14 tools: the MoE MTP loop's real programs co-simulated, the bound at the MTP image's slot count, the expert server replayed, card session mtp1 (not staged). moe_prefill_cosim.py mtp MODEL --prefix 4:8: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
2026-10-14 pack_pool.py extend --copy auto|reflink|full: the source pool's experts reflinked where the file system can (btrfs, XFS: cp --reflink=always, then the clone cut to the experts and extended by the MTP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
2026-10-14 MoE MTP chat: a turn rolls back to the last reply again. MTPDecoder.prefill's layer-by-layer branch ran the prompt's first conv_k - 1 rows (the rows kernel's) without on_run, so Chat.fed missed them: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
    [server_replay.py, test_mtp_moe.py]
2026-10-14 MiniCPM-V's images under MTP: MTPDecoder.prefill(vis=) passes a prompt's image rows to the layer-by-layer prompt (Engine.prefill_layers' copy runs; the MTP layer's input of an image token is its plac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
2026-10-14 tests/test_minicpmv.py: test_pack_pool_keys_the_experts_alone's stub of pack_pool.image takes mtp. pack_pool.py's main calls image(a.model, a.wformat, a.mtp) since its --mtp (an MTP image's pool), an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
    [test_minicpmv.py]
2026-10-14 The MTP loop's V and E in two parts when over IMEM. MiniCPM-V's formats (DeltaNet in layers 0-19 and the MLPs int8) give its layers two runs, each a loop body of its own, so its programs double: V 61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
2026-10-14 The split V / E without DRAM of its own: an MTP image's layout as before the split, so the programs of a model whose V and E fit (the 35B's) stay byte for byte. The second part's chain entry goes in 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
2026-10-14 docs/mtp.md 10.3: the split V and E (MiniCPM-V's two runs of layers: V 6173 -> 3014 + 3192 instructions, E 4566 -> 2262 + 2329; the cut at a run's first layer, the residual through m.hid, part 1 in t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
2026-10-14 server_replay.py replay --slots N (repeated: a sweep): each layer N slots instead of the record's, the same routing on a cache of another capacity (the warm set while slots last). O's need-line count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
2026-10-14 docs/offload.md 15.4: O is dropped, count and reorder both. server_replay's capacity sweep (the 35B's and the 26B's les1 records on 10 to 64 slots a layer): need-line counting is -1.5% to -2.6% decod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
2026-10-14 run_generate serves the card until it halts. With the host's hook (a streamed MoE's expert and row servers) BoardBackend.run_generate served the card only until the n-th token landed, then waited for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
2026-10-14 tests/test_mtp.py: the RTL loop tests compare DRAM outside the chain area's wait entries. test_mtp_loop_on_rtl and test_mtp_sampled_loop_on_rtl failed on np.array_equal(ISA DRAM, RTL DRAM) with the t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
    [test_mtp.py]
2026-10-14 tests: the MoE board-model tests take the session's board configuration (conftest.sim_board_config). test_moe_on_board_model in test_qwen35_moe.py, test_gemma4_moe.py and test_lfm2_moe.py built their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
2026-10-14 otpu_slice: the SW port's output register on every target, one design; SW_REG and its plumbing gone. PR #7 put the QST writes' SW port (sw_req / sw_addr / sw_wdata / sw_be) behind flip-flops on the A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
    [flow.py, otpu_asic_top.sv, otpu_board.sv, otpu_slice.sv, otpu_top.sv, rtlsim.py, target.py, tb_board.sv]
2026-10-14 mtp1.sh: every other file of 100 MB or more under ~/openTPU, ~/otpu-build and /data/otpu out of the page cache before a pool's read (DROPOTHER, its default now all of ours). mtp1's second run (mtp1b,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
2026-10-14 MTP: the loop's first run drafts the prompt's last row (F1b, after session mtp1c). A layer-by-layer prompt's last row drafted in a 1-row MTP run of its own after the head, compiled at its position an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
2026-10-14 docs/asic.md: the card's results at release r2 (ACT_ROWS 8, the MXU's macros by its columns), the previous card point as before. The Results table takes three columns (nangate45-small, r2 at ACT_ROWS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
2026-10-14 prefill.tiled: today's prompt runs on a tie. Where today's runs cover a bucket with as many rows as its tile (R >= T), its P and L runs are today's: at equal rows the tile was the slower on every pro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
2026-10-14 docs/offload.md 15.6: session mtp1c (passed: decode 1.127x, MTP alone against production's S; TTFT +0.02 to +0.88 s), its TTFT by part (the prompt's last call's extra row, the first draft's run, the 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
2026-10-14 tools/offload/sessions/mtp2.sh: session mtp2, mtp1c's A / B with B on F1b and F2, then a traced pair. A = production's host (deploy_hostr21_b10245f5), B = this tree with --mtp from mtp1's MTP pool; t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
2026-10-14 gen_warm: the decode loop's bucket programs compiled ahead, in the background, when otpu-chat or otpu-serve opens its engine. A reply that reached a bucket for the first time in a tree waited for its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
2026-10-14 docs/offload.md 15.6: another 32K-id set for the MTP draft head does not pay. UltraChat's (MIT, 10M reply tokens) 32K most frequent ids cover fewer reply targets than the lowest 32K (gen-base 0.902 a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
2026-10-14 progcache: OTPU_VISION_WARM out of the key (RUNTIME_ENV). vision_warm's switch only says whether the engine starts the tower's warm process; no program or wait entry depends on it, but every OTPU_* v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
    [progcache.py, test_progcache.py]
2026-10-14 Engine.tile_rows: a MoE model's expert-major runs tiled, T rows a run, beside today's layer-major calls; and a fix: tile_runs tiled every layer run of layer_major's R rows, also in the calls gate_exp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
    [chatmoe.py, test_em_tile.py]
2026-10-14 The PHY's read latency is the bitstream's: no host file changes with it. sdram_init.py's read_latency (8; 9 with gen_core.py --rd-reg, r2.1's m8 core 35bd2958) is read by no module under opentpu/ and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
    [test_selfcal.py]
2026-10-14 otpu_slice: port B's output and input registers on every target, one design. Port B's requests (b_req, b_tag, b_we, b_wmask, b_wdata, b_addr, b_par) leave the slice from an output register, b_req its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
    - Why: the ASIC card point (a8, a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
    [otpu_asic_top.sv, otpu_board.sv, otpu_pkg.sv, otpu_slice.sv, tb_board.sv, test_target.py]
2026-10-14 tiled.layer_family: the family by the image's class or a base class. MiniCPM-V's Image subclasses Qwen3.5's, and layer_family read the class's own module (minicpmv, not in LAYER_KERNELS), so MiniCPM-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
    [test_minicpmv.py]
2026-10-14 tiled: the looped attention (docs/tiled_prefill.md 13). A tiled prompt run's attention ran unrolled, an entry per KV head, query part and packed tile, which filled IMEM past the first buckets (Phi-4-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
2026-10-14 qual refs: the xl prompt, about 1,400 tokens in prompt runs through buckets 1-6. refs.py's run flag xl (--xl): LONG_TEXT repeated (XL_TEXT), cut to at most XL_TOKENS (1,400) tokens, at a KV capacity 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
    [refs.py, test_qual_refs.py, test_qual_sh.py]
2026-10-14 asic: mxu_macros.tcl places the TMEM by its readers with TMEM_GAP_UM (off unless set). The macro placer put the card's TMEM (16 1RW1R 4096x32 macros, one copy) in a 4 x 4 block in the core's bottom-r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
2026-10-14 asic: the card point takes the TMEM by its readers and global routing at 7%; every point's ports latency-neutral after CTS. flow.py's card: tmem_gap 100 (config.mk TMEM_GAP_UM, mxu_macros.tcl's TMEM 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
2026-10-14 otpu_slice: port A's output register on every target, the card's DRAM adapter's own moved into the slice. The MXU's scale reads (a_req, a_addr) leave the slice from a register, a_req its valid bit, w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
2026-10-14 perf_ddr: the program's WAITC wait entries. Since release-2 (4b018ac2) the card's target has SEQ_WC, so rtlsim.BOARD_UARCH builds otpu_seq with WAITC, but perf_ddr's boot image held the program alone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
2026-10-14 tb_board: port A's held beats checked against the flush, beside the slice's port A register. otpu_native_dram's a_flush (a run's reset || a program load || a WAITW's word holding: where the host may 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
    [otpu_slice.sv, tb_board.sv, test_board.py]
2026-10-14 docs/tiled_prefill.md 14: MoE expert-major runs in tiles. Qwen3.5-MoE's expert-major calls (MiniCPM-V's language model and qwen35-35b) run their layer runs in tiles of 8 rows (tiled.LAYER_ROWS, at mo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
2026-10-14 otpu_vpu: the stream grant's lanes take per-lane copies of it (ss_act, the ASIC card point's worst register path). ss_act (stream mode; ss_gnt to the DMA) selected every lane's RDOT term (rsa / rsb, 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
    [otpu_se_tail.sv, otpu_vpu.sv, test_target.py]
2026-10-14 tests/test_mtp_moe.py: 64 MiB of DRAM. With Qwen3.5-MoE's tiles on by default (em-tile 2bb7bb0b) a tiny int8 MTP image holds the mask tiles and the I/O scratch and needs 32 MiB, the configuration's w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
    [test_mtp_moe.py]
2026-10-14 MTP engines on the card path run their layer runs untiled (a workaround in unkeyed files: progcache.source() stays 27f21043's, 6805fff8). With Qwen3.5-MoE's tiles on by default (em-tile 2bb7bb0b), an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
    [chatmoe.py, streamed.py, test_mtp_moe.py]
2026-10-14 tests/test_mtp_moe.py: the 35B MTP loop programs' sum with the image's mask tiles. test_a_loop_program_that_fits_is_not_split (it runs where models/Qwen3.5-35B-A3B is: hwe-bench; the Mac skips it) fa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
    [test_mtp_moe.py]
2026-10-14 Tiled expert-major layer runs on an MTP image's committed slot, and MTP engines tiled again. With Qwen3.5-MoE's tiles on by default (em-tile 2bb7bb0b), an MTP engine's next chat turn (mtp.MTPDecoder: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
2026-10-14 A tile's MoE prologue takes its rows at once. tiled.qwen35_layer_tile ran moe.moe_prologue_rows over groups of 2 rows (a need line's LINE / 4 / k ids at the 35B's k = 8), so an 8-row tile streamed th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
    [test_em_tile.py]
2026-10-14 A tiled MoE image's DeltaNet rows run a tile's at a time where MCOLS takes them. layer_variants' DeltaNet runs were at most the image's gr / on rows (grows: max(rows, RUN_ROWS) = 4), so on r2.1's m8 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
2026-10-14 tools/offload/sessions/emprol.sh: em-prologue's card A/B (docs/tiled_prefill.md 14.3). Arms A (the release's host, default the r2.1 deploy's) and B (em-prologue's tree), each its own opentpu and chat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
2026-10-14 docs/dataflow.md 4.9.1: the chunked delta rule on the MXU, accuracy and cost (no kernel), and a short-K MM as an ASIC architecture item (7.2 item 8). The chunked form (Hugging Face's torch_chunk_gate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
    [dn_chunk.py]
2026-10-14 chatmoe --trace: each turn's host phases up to its first token. Session mtp2 (2026-10-14) left +0.10 to +0.13 s of MTP's TTFT B - A in turns 2-5 outside the prompt's calls, which the call times canno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
2026-10-14 otpu-serve --mtp: every request decodes with the MTP drafter, its loop on the card (opt-in, on mtp-slot-fix's tiled MTP engines (ef62bc04); a streamed Qwen3.5-MoE from its -mtp pool, --mtp-from for M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
    [api.py, kvio.py, scheduler.py, store.py, test_serve_mtp.py]
2026-10-14 tests/test_lfm2_moe.py: test_pool_file_is_the_same_pool takes moe.rewarm's stopped read. On a loaded host the second engine's moe.rewarm (882b008f) found the open's warm read of the pool still runnin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
    [test_lfm2_moe.py]
2026-10-14 docs/tiled_prefill.md 15: the chunked DeltaNet, sized and parked (no code: r2.2's prefill ends at section 14). The candidate of docs/dataflow.md 4.9.1 (every matmul split, C = 64: +0.13 dKL on MiniCP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
2026-10-14 Session scripts: no apostrophe inside a ${NAME:?word} / ${NAME:-word} word. In an unquoted expansion bash takes an apostrophe in the word as an open single quote, closed only by the next one: emprol.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
2026-10-14 tests/test_rtl.py: nangate45-small's 8 failures were the tests' assumptions, not the target's limits. (1) The release-r2 TMEM tests (test_one_copy_replays_make_progress, test_one_copy_tmem_of_128k_wo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
    [test_rtl.py]
2026-10-14 docs/tiled_prefill.md 14.3: em-prologue on the card. Session emprol (2026-10-14, opentpu ~/otpu-build/emprol/run-1014-1320): r2.1's m8 bitstream 039b34d5, production's host d57a3568 as A against em-p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
2026-10-14 docs/offload.md 15.7: MTP on m8, and the compiles in its TTFT. Session mtp_rel (2026-10-14, right after r2.1's promotion: bitstream 039b34d5, host d57a3568): (a) production's host with OTPU_TILE=0, c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
2026-10-14 docs/asic.md: the card point at global routing with port A's and B's boundary registers (r3, main 7e42a626) and the VPU's grant copies (r4, main 1aad9195), against tm100 (06c4be2d). Each run goes fro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
2026-10-19 timing-ffs WIP: cycle-exact register copies at the long-wire drivers (TMEM pump per RAM, MXU decoded scale per column and result FIFO write counters per slice, VPU fill index per lane, ACT RAM second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
2026-10-19 timing-ffs WIP: the VPU's pipeline enable as a copy per lane (g_enl, kept), taken by the lanes' stages, the SE tail's units (cen per lane) and the composites' lanes (otpu_se_comp en_l)
2026-10-19 tests/test_target.py: the long-wire drivers' per-consumer copies (VPU enable and fill index per lane, MXU decoded scale per column and FIFO write counters per slice, ACT RAM second hop per column, TM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
2026-10-19 timing-ffs WIP: otpu_seq's command store written a cycle after the dispatch with wait counts (g_cmd g_wq: the enable and slot a kept copy per unit, the command one register), a slot starting two cycl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
    [otpu_seq.sv, test_target.py]
2026-10-19 otpu_actram: main's write stage again (one wide byte-placement register, the pieces' address and select copies), batch 1's copy of the second hop per column reverted. The copy took the wide stage wit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
    [otpu_actram.sv, test_target.py]
2026-10-19 asic: the card's global-route repair as repair_timing only (asic/nangate45/grt_repair.tcl, PRE_GLOBAL_ROUTE_TCL, flow.py's grt_repair on the card point): the GRT step's repair_design a no-op (placeme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
    [flow.py, test_asic_flow.py]
2026-10-19 docs/asic.md: the card's global-route repair as repair_timing only (grt_repair.tcl): main's card 2.497 -> 2.000 ns with a 0.5 ns margin in 100 s; with 1.0 it stalls at 1.99 ns on the VPU's floating-p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
2026-10-19 docs/timing_ffs.md: the timing study. Where the delay is (the FPGA card's near-critical paths 88% route, the ASIC's unrepaired drivers), the path classes and the fix each needs, Vivado alone (~137 MH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
2026-10-19 fanout: the widest LUT RAMs as block RAMs read ahead, and two enables gone. otpu_ram_1r1w_ra (rtl/tech, both families): rd is the word at the read address register with every write to the last edge i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
    [otpu_dma.sv, otpu_mxu.sv, otpu_native_dram.sv, otpu_slice.sv, otpu_tech_ram.sv, otpu_tmem.sv, tb_tech_ram.sv, test_target.py]
2026-10-19 fanout: late pushes off LUT RAM write enables, the SW queue's data as block RAMs read ahead, alpha off the TMEM grant. otpu_afifo (OOO 0: u_aq, u_ad, u_xq, u_xd): the RAM writes the tail slot every c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
    [otpu_afifo.sv, otpu_mxu.sv, otpu_native_dram.sv, test_target.py]
2026-10-19 fanout: the VPU's enable copies per lane and per consumer. g_wbuf's g_enl keeps four copies per lane (u_en, u_ec, u_et, u_ev), each loaded with en_rd as en_r is: the lanes' own stages (en_l), the com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
    [otpu_vpu.sv, test_target.py]
2026-10-19 otpu_vpu: the enable copy per lane again (batch 7 reverted: 0c0b16c8's four copies per lane and consumer, and otpu_vtree's en_l). On the m8 card at the 150 MHz equivalent (b_t7_150 against b_t6_150, 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
    [otpu_vpu.sv, test_target.py]
2026-10-19 otpu_mxu TQ: the epilogue on a registered advance and a TMEM request queue. The epilogue (the drain's lanes, the read-modify-write, RMAX, the ASCALE loads) advanced on the TMEM grant itself, which re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
    [otpu_mxu.sv, otpu_slice.sv]
2026-10-19 test_target: the MXU's epilogue advances on a register (TQ): the grant reaches only the TMEM interface's queue (g_tq: pop, push, the read taken), ea is a flip-flop that takes t_lost, the slice wires 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
    [test_target.py]
2026-10-19 otpu_mxu TQ v2: the MXU's reads not granted, its writes through a queue, the epilogue's advance from flip-flops. 72cbb745's TQ kept the read in the granted beat, and b_t8_150 (the m8 card at the 150 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
    [otpu_mxu.sv, otpu_slice.sv, test_target.py]
2026-10-19 ypcb-00338: a core clock CLK2X can divide at 150 MHz. bd_native.tcl's core MMCM ran its VCO at 800 MHz (50 MHz x 16), which has no even divider for 150 MHz (5.333), so CORE_MHZ 150 with the pumped TM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
2026-10-19 otpu_mxu: three of b_t9_150's last paths. (1) RMAX's compare a stage after its keys: fkey of the fmadd's sum, the lanes' selection per column, a 32-bit compare with mk and the update's enable were on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
2026-10-19 b_t9_150's other three paths, for a real 150 MHz build. (1) otpu_vpu: the enable's copies three per lane, one per consumer group (en_l the lanes', en_t the tail's units', en_c the composites' lanes')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
2026-10-19 otpu_vpu: the enable's copies one per lane again (eb17a348's per-group split reverted). It repeats batch 7 (0c0b16c8, reverted in 402bb3bd), and b_t9_150's near-critical loads show why it would not h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
    [otpu_vpu.sv, test_target.py]
2026-10-19 Two of r150a's paths (the m8 card at a real 150 MHz, 18168e94: core -0.087 ns, 172 failing). (1) otpu_tmem: the pumped TMEM's word into the units' capture registers (the VPU's xa / xb, the quantizer'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
    [otpu_mxu.sv, otpu_tmem.sv, test_target.py]
2026-10-19 otpu_seq: the VPU wait hold (wc_hold) from a flip-flop, vnx_q: vout at the next VPU instruction's index (wd_n + 1 mod VN), loaded with its next value (a VPU dispatch sets bit wd_n and moves wd_n on, 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
    [otpu_seq.sv]
2026-10-19 otpu_vpu FB: a front and a back end, the back end's enable from flip-flops. With WBUF (the board) the VPU's one enable reached ~21k registers (the lanes, the trees, the composites, the tail) and was 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
    [otpu_se_comp.sv, otpu_vpu.sv, tb_se_comp.sv]
2026-10-19 otpu_mem_ch: XDMA's write packing loads each 128-bit lane of x_wbuf while its beat is offered (x_wvalid and the lane), neither cleared on a push nor reset. Its bytes are written only where the strobe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
    [memch_test.py, otpu_mem_ch.sv]
2026-10-19 TMEM's read arbitration from flip-flops: the MXU's read by bank, rpv per bank. r150c (the m8 card at a real 150 MHz, 6501e15e) had its worst path from the MXU's request register through the lanes' ba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
    [otpu_mxu.sv, otpu_slice.sv, otpu_tmem.sv, tb_tmem.sv, test_rtl.py, test_target.py, tmem_nc_top.sv, tmem_pump_top.sv]
2026-10-19 TMEM's reads by bank from flip-flops for the DMA, the quantizer and the VPU too. r150d (the m8 card at a real 150 MHz, 671b4265 with a 0.15 ns core margin) had its worst core -> clk2x classes from th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
    [otpu_dma.sv, otpu_quant.sv, otpu_slice.sv, otpu_tmem.sv, otpu_vpu.sv, test_target.py]
2026-10-19 otpu_tmem_breq moves to otpu_pkg.sv: the units' own source lists (the SE VPU's testbench, the tourney's components, the out-of-context runs) have the package file but not otpu_tmem.sv, so with bc7c33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
    [otpu_pkg.sv, otpu_tmem.sv]
2026-10-19 ypcb-00338: OTPU_TMEM_PBLOCK, the TMEM in a hard pblock (pblock ranges, e.g. CLOCKREGION_X0Y3:CLOCKREGION_X1Y4). At a 150 MHz core the channel whose PHY rows held the pumped TMEM read ECC errors unde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
2026-10-19 docs/timing_ffs.md: section 8, r150h / r150i (the TMEM in a hard pblock between the PHYs' rows, X0Y3:X1Y4, f5eb87c5). Timing fails there (r150h core -0.286 / clk2x -0.086 ns; r150i with OTPU_SYS_MARG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
2026-10-19 opentpu.host.loadcal: the DDR3 read taps centred under the core's load, on a configuration's first scrub when the core clock is not the controllers'. At a 150 MHz core (r150fp, 1da7d3b9) four card lo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
    [board.py, loadcal.py, test_loadcal.py]
2026-10-19 opentpu.host.loadcal: centre under prefill's load (16 rows of activations against fp4 weights beside the DMA), not turnaround.py's single row. r150fp's window with the first version (r150fpl: product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
    [loadcal.py, test_loadcal.py]
2026-10-19 opentpu.host.loadcal: each lane's eye chosen under load over its read bitslip and the one either side, not the calibration's (the widest window at idle, the first of equals). The same data reads righ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
    [board.py, ddrcal.py, loadcal.py, test_loadcal.py]
2026-10-19 docs: the MXU array's place and each lane's eye under load at 150 MHz (litedram.md section 10, timing_ffs.md section 8). litedram.md "The array's place": the read windows under each core load with th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
2026-10-19 docs: r150o is production at 150 MHz (2026-10-19). Its second deploy window, on production's host ec87de44 with loadcal 6b8d9d4c and 1c4b3bf8 (each lane's eye chosen under prefill's load), read ECC 0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
2026-10-20 docs: add ASIC flow section to main README
2026-10-23 bend: the MXU (MM: int8, int4, fp4, NVFP4, PAIR, RSC, UNIT, ACC, ASCALE, RMAX; the exact 64-bit sum), QACT and QST in sim.bend; opentpu/bend_sim.py (the server's driver, BendBackend for the Engine) a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
2026-10-23 bend: STREAM in the Bend ISA simulator; isasim: a unary scalar op does not read b
    bend/sim.bend x.stream (isasim Slice._stream): the descriptor's payloads and its checks in
    isasim's order (38 descriptor / operands, 7 TMEM ranges, 6 DRAM ranges), the slots, constants
    and row scalars read first, then each row: REDUCE A (slot / self / constant dot, or the row's
    max under RMAX's order: rm.row moved above the dispatcher), the scalar ops one row at a time
    (each op evaluates only its own function), MAP U, Q's dot or O's register, out_p2, the row
    written back; O and rsave last. A TMEM stream in place whose rows overlap one another is read
    whole before any row is written in isasim: those rows wait in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
2026-10-23 bend: the MXU's rows and outputs in parallel (bend/simpar.bend, fork-join over Array.fork/join, LEAF 4096 output blocks); sim.bend's MM as templates (mm.ck ~rw, mm.rows/mm.js ~ns) so the sequential a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
2026-10-23 tests/test_bend.py: the Bend simulator's gate. The laws (bend/PROOF.bend: ALL PROOFS CHECK), fp32 / sim / machine.bend free of @unsafe (total, terminating), every VOP function and operand mode on ran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
    [test_bend.py]
2026-10-23 bend: word.bend (the machine's word helpers, out of sim.bend) and its laws beside fp32's; bend/prog/LAWS.bend + PROOF.bend, the program laws on sim.bend; tests/test_bend.py checks both, and --verdict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
2026-10-23 bend/cache: the expert cache's replays in Bend (cachesim.simulate's static, lru, lru_layer, lfu and opt, miss for miss; main.bend runs a sweep's replays at once, tools/offload/cache_bend.py drives it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
    [cache_bend.py, cachesim.py, test_bend.py]
2026-10-23 cachesim: --bend, the policies Bend has (static, lru, lru_layer, lfu, opt) replayed in bend/cache, every replay of a text at once (no prediction coverage: Bend returns misses a token, not the miss se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
2026-10-23 docs/bend.md: the simulators in Bend, their laws, checks and speed. bend_sim: BendMachine.slices shows each slice as isasim's do to a WAITW host (polling, reg, holds, m32, dram), and the host's turn 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
    [bend_backend.py, bend_sim.py, test_bend.py]
2026-10-23 docs/bend.md: the shadow's final counts (15,444 runs identical, 19 on the same error over 18 test files; hwe-bench B's 5 mismatches only the HALT CHAIN count the old shadow compared, the five tests' 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
